tadashi101/teen_circle/README.md

# teen circle  
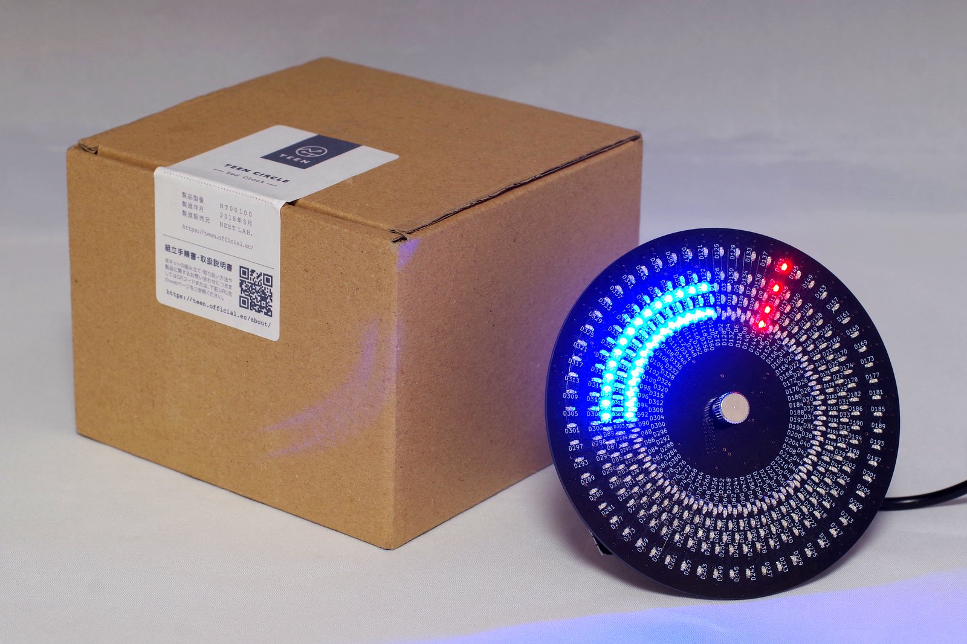
[picture p1: image/image_README.JPG]
TEEN_CIRCLE
  
  
teen circleのgithubのページです
回路図、ファームウェア、組み立て説明書、使い方説明書などをまとめています  
  
Rev２から調光機能を追加しました。[設定方法はこちら](doc/usage.md)  
スマートフォンの画面からLEDの明るさを変更することができます  
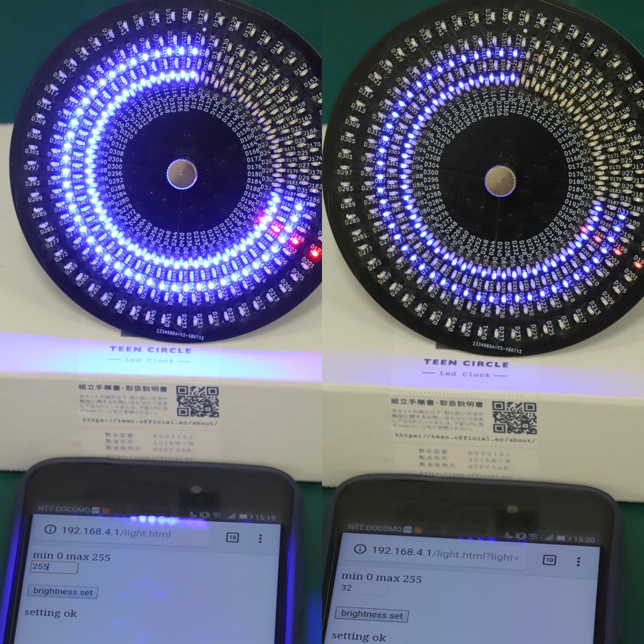
[picture p2: image/Rev2/image_rev2_comp.jpg]
light_comp
  

Rev3基板からUSB PD(9V)電源で動作するように変更されました。電源基板のレギュレータが熱くなる問題が解決されています。  
ファームウェアはRev 2以降で共通です  
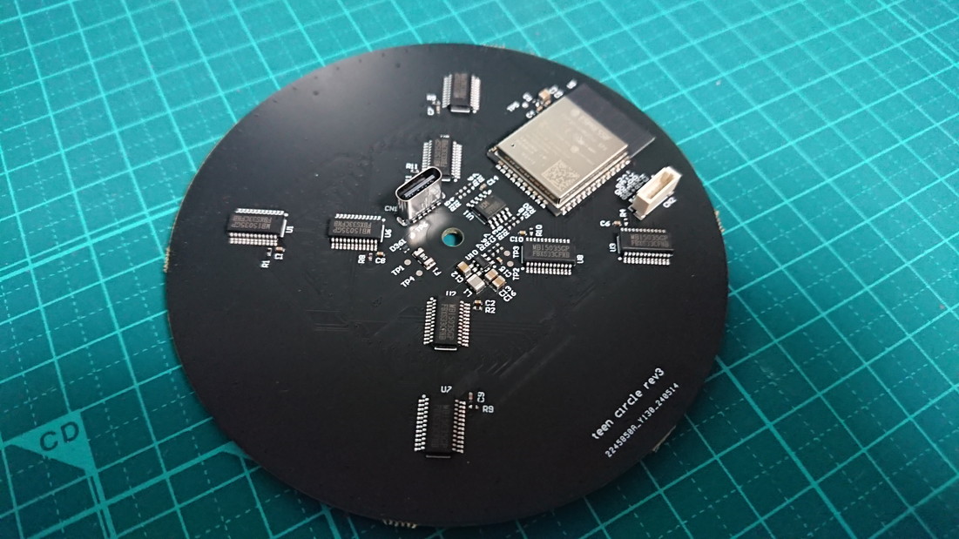
[picture p3: image/Rev3/image_rev3_usbc.jpg]
  
  
紹介動画  
表示できません (http://www.youtube.com/watch?v=WW388IgG8ik)
  
## Documents  
[組み立て説明書](doc/buildguide.md)  
組み立て方の説明です、部品の半田付け、組み立てなどが記載してあります  
  
[使い方説明書](doc/usage.md)  
[使い方説明書(Wi-Fi Manager対応版)](doc/usage_2.md)  
使い方の説明です、時刻の設定方法が記載してあります  
  
[時刻の読み方](doc/dial.md)  
時刻の読み方が記載してあります  
  
## ファームウェア  
[書き込み方法](doc/flash.md)  
使用してるマイコンESP32の書き込み方法を記載しています
