tadashi101/teen_circle/firmware/Rev2/led_clock/README.md

# TEEN CIRCLE Rev.2 向け NTP & Wi-Fi Manager 対応ファームウェア

## 使い方

1. Arduino IDE で、`led_clock.ino` をビルドし、書き込みます。ファームウェアの書き込み方法については [こちら](https://github.com/mizuhiki/teen_circle/blob/master/doc/flash.md) を参照してください。
2. 続けて`flash_spiffs.bat`を実行してWeb UI用のデータをアップロードします。失敗するときやWindows以外のOSの場合は書かれているスクリプトを各自の環境に合わせて修正してください
