tadashi101/teen_circle/doc/flash.md

# ファームウェアの書き込み方法
同梱されてるWi-FiモジュールESP-WROOM-32(ESP32)にはあらかじめファームウェアを書き込んでいます
このページの内容はファームウェアをアップデート、もしくは変更したい人向けになります  
  
## Rev2基板までの場合
1. ハーフピッチで2列の[ピンヘッダ](http://www.aitendo.com/product/6880)、[ピンソケット](http://www.aitendo.com/product/11345)などをJ3に半田付けします  
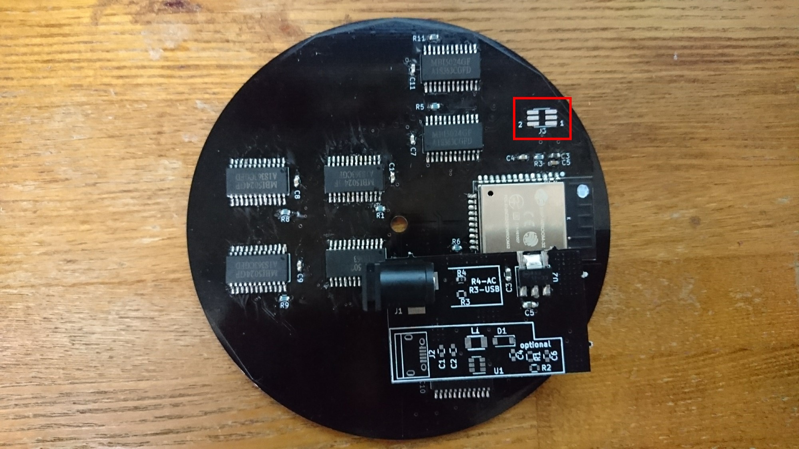
[picture p4: image/image_flash_1.jpg]
J3
  
  
2. 3.3VのUSB-UARTを用意します。[秋月電子](http://akizukidenshi.com/catalog/g/gM-05840/)や[aitendo](http://www.aitendo.com/product/2890)などで購入できます  
  
3. J3の3ピンがESP32側のRX,5ピンがTXなのでUSB-UARTのTXとRXを半田付けし、さらにGNDもつなぎます  
秋月電子さんのUSB-UARTの場合は以下の様な接続になります  
  
| USB-UART | 　 | J3 |
|---:|---:|---:|
| GND　黒 | - | GND 2ピン |
| CTS　茶 |  |  |
| ５V　赤 |  |  |
| TXD　橙 | - | RX ３ピン |
| RXD　黄 | - | TX ５ピン |
| RTS　緑 |  |  |
  
J3のピン配置は以下の様になります  
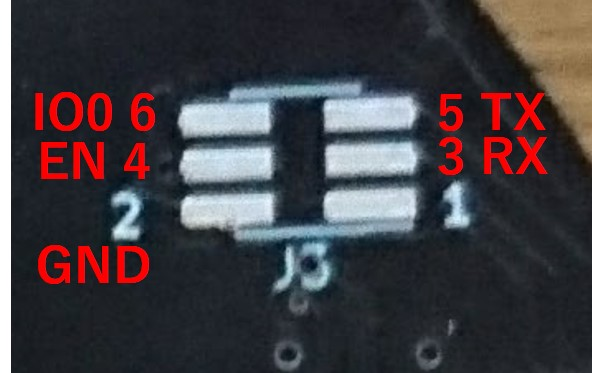
[picture p5: image/image_flash_2.jpg]
J3ピン配置
  
  
4. ESP32のファームウェアを書き込むモードにするためにはEN(J3:4ピン)とIO0(J3:6ピン)をGNDに落とす必要があります  
IO0(J3:6ピン)をGNDに落としたままにするとファームウェア書き込みモードに固定されるため、  
EN、IO0とGNDの間に[スイッチ](http://akizukidenshi.com/catalog/g/gP-03646/)を接続し、スイッチを押すとEN,IO0がGNDと接続されるようにします  
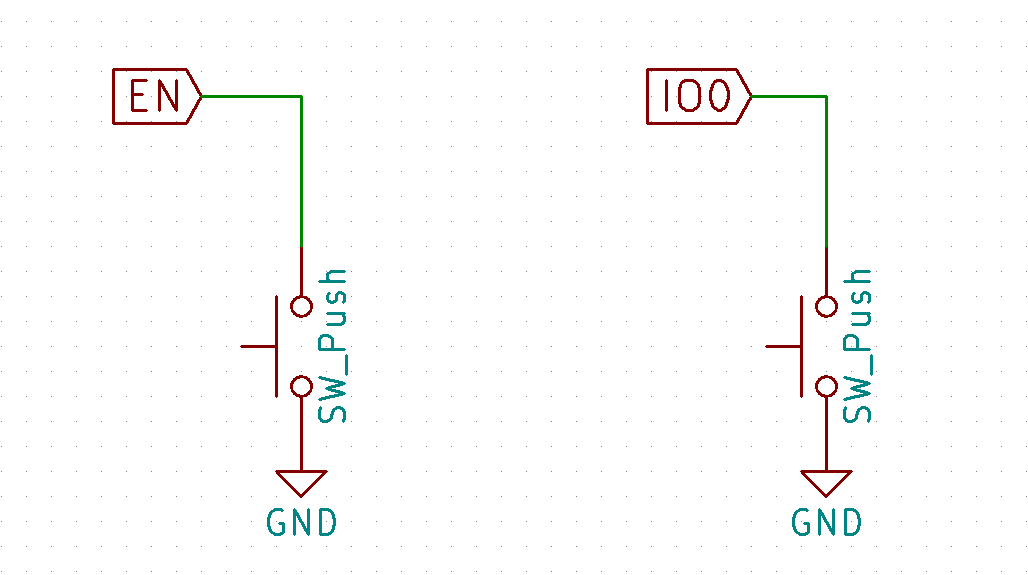
[picture p6: image/image_flash_3.PNG]
EN,IO0接続
  
  
5. ファームウェアをビルドします。ビルドする方法は将来書くかもしれません  
  
6. ファームウェアを書き込みます  
(1)Arduino IDEの場合  
スケッチ→マイコンボードのの書き込みをクリックします  
Connecting.......の表示になると、ENとIO0両方のスイッチのボタンを押し、ENのスイッチだけボタンを離します  
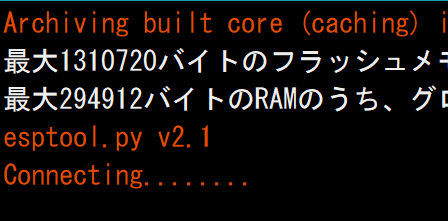
[picture p7: image/image_flash_4.PNG]
Connect
  
Writing～の表示になるとIO00側のボタンも離します  
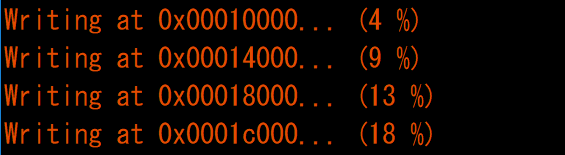
[picture p8: image/image_flash_5.PNG]
Writing
  
Hard resetting..の表示になったらファームウェアが書き込めてます  
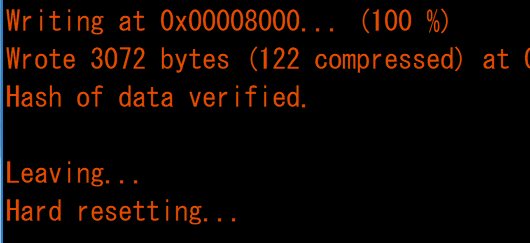
[picture p9: image/image_flash_6.PNG]
Hard_reset
  
リセットするためにENのスイッチのボタンを押して、離します

これでリセットがかかり、書き込まれたファームでESP32が起動します  

## Rev3基板の場合
1. JSTのSH6Pコネクタ付ケーブルまたは[互換品](https://akizukidenshi.com/catalog/g/g114535/)を用意します
  
2. [CP2104/CH9102搭載 ESP32 ダウンローダキット](https://akizukidenshi.com/catalog/g/g117240/)または相当品のESP32書き込み基板を用意します
  
3. CN2とダウンローダキットをSH6Pケーブルで接続します  
  
| ESP32ダウンローダキット | 　 | CN2 |
|---:|---:|---:|
| GND | - | GND 6ピン |
| G0 | - | PROG 5ピン |
| EN | - | EN 1ピン |
| RXD | - | RX ３ピン |
| TXD | - | TX 2ピン |
| 3.3V | - | 3.3V 4ピン |
  
ピン配置は基板のシルクも参考にして接続してください
CP2104/CH9102搭載 ESP32 ダウンローダキット以外のESP32書き込み基板を使用する場合はTXD/RXDの定義が逆のこともありますので注意ください
    
4. ファームウェアをビルドします。ビルドする方法は将来書くかもしれません  
  
5. ファームウェアを書き込みます  
(1)Arduino IDEの場合  
スケッチ→マイコンボードのの書き込みをクリックします  
Connecting.......の表示になると、ENとIO0両方のスイッチのボタンを押し、ENのスイッチだけボタンを離します  
Connect  
Writing～の表示になるとIO00側のボタンも離します  
Writing  
Hard resetting..の表示になったらファームウェアが書き込めてます  
Hard_reset  
リセットするためにENのスイッチのボタンを押して、離します

これでリセットがかかり、書き込まれたファームでESP32が起動します
