tadashi101/teen_circle/doc/dial.md

# 時間の読み方

TEEN CIRCLEは、組み立てた後も楽しく時計を使っていただくため、特徴的な文字盤のデザインとなっています  
LEDの文字盤ならではの時刻表現は、ほんの少しコツを掴めば、アナログ時計や７セグの時計よりも直感的に時の流れを感じてもらうことができます  
  
## 「時」の読み方  
青色のLEDは「時」を表します  
日の昇り沈みを示すように、午前は青色LEDの点灯数が増え続け、午後は順番に消灯していきます  
午前と午後で時刻の表示が異なるのが特徴です    

午後１２時（午前０時）では青色のLEDが１列点灯している状態になります  
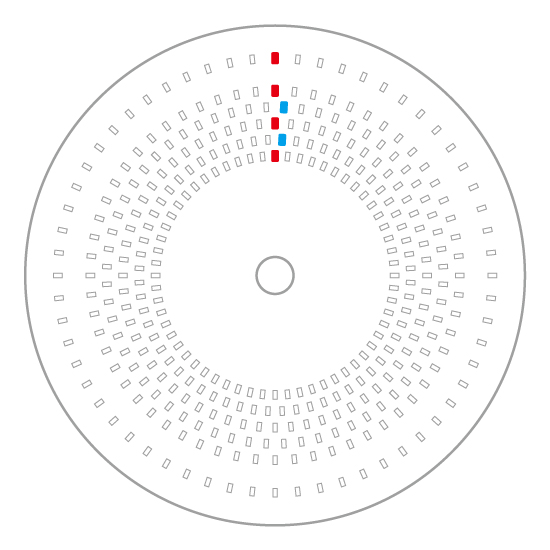
[picture p10: image/image_dial_01.jpg]
文字盤_0:00
 
  
午前中は一時間ごとに点灯する青色のLEDが増えます  

下図は「午前３時ちょうど」です  
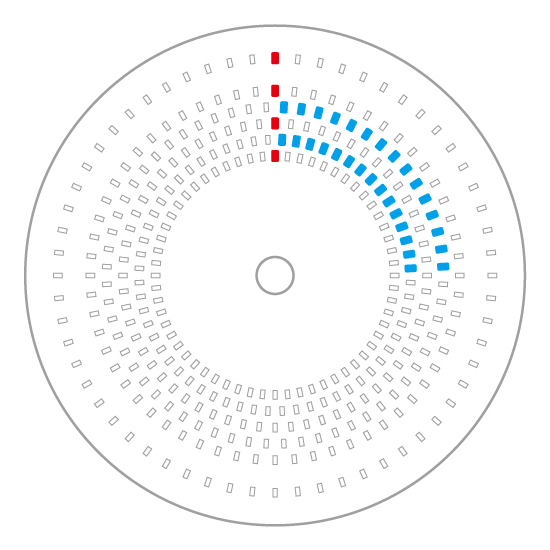
[picture p11: image/image_dial_02.jpg]
文字盤_3:00
  
  
午前１２時(正午)になると、青色のLEDは一周点灯する状態になります  
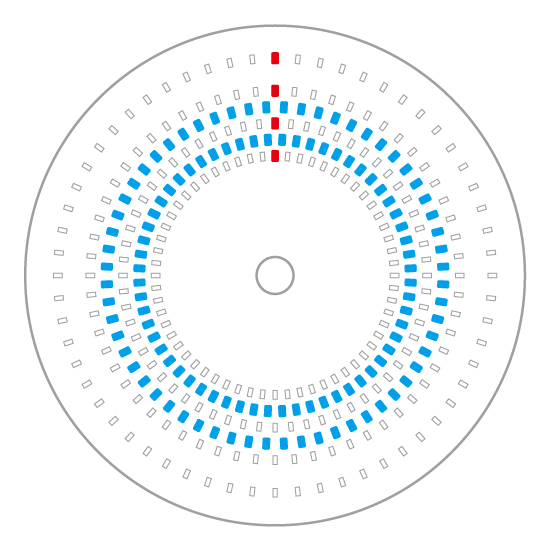
[picture p12: image/image_dial_03.jpg]
文字盤_12:00
  
  
午後１時からは、青色のLED表示が順番に消えてます  
下図は「午後３時（15時）ちょうど」です  
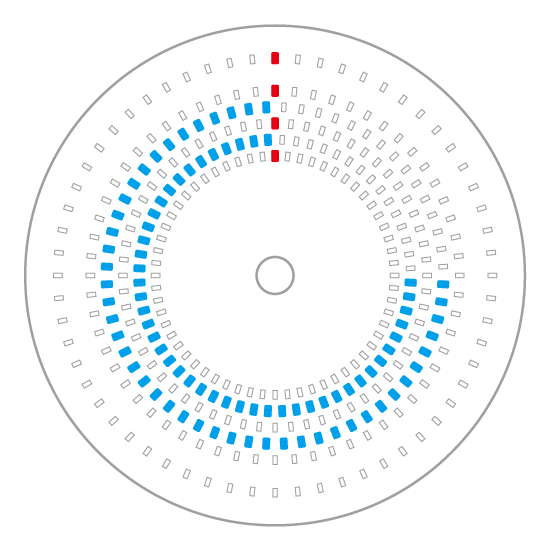
[picture p13: image/image_dial_04.jpg]
文字盤_15:00
  

## 「分」の読み方  
赤色のLEDは「分」を表します  
赤色のLEDはアナログ時計の分針と同じ動きをします  
下図は「午前９時１０分」です  
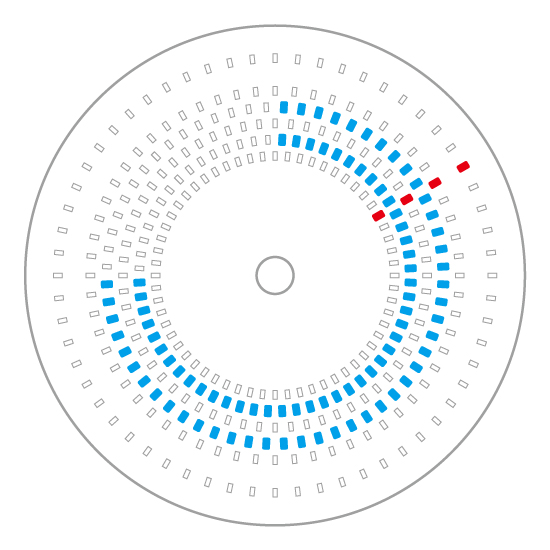
[picture p14: image/image_dial_05.jpg]
文字盤_9:10
  

分針である赤色のLED表示は午前も午後も同じ動きをします  
下図の場合は「午後９時１０分（２１時１０分）」です  
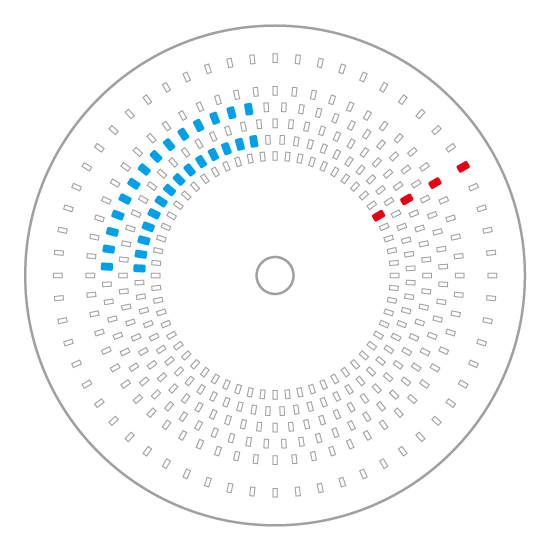
[picture p15: image/image_dial_06.jpg]
文字盤_21:10
