tadashi101/teen_circle/doc/buildguide.md

# 組み立て説明書  
## 内容物  
  
| 名称 | 必要数 | 備考 |
|---:|---:|---:|
| LED基板 | 1 |  |
| 電源基板 | 1 | 実装済み |
| LED赤 | 240 | 少し多めに入れてます |
| LED青 | 120 | 少し多めに入れてます |
| LEDドライバ MBI5024 | 8 |  |
| ESP-WROOM-32 | 1 |  |
| 抵抗10k 1608サイズ | 11 | 1個余分に入ってるかも |
| コンデンサ10u 1608サイズ | 1 | Rev2から予備も含めて3つ入れてます |
| コンデンサ0.1u 1608サイズ | 10 | 1個余分に入ってるかも |
| ピンヘッダオス 2×3 1.27mmピッチ | 1 | Rev2から2.54mmピッチ |
| ネジ | 1 |  |
| スペーサー | 1 | (Rev2から廃止) |
| Tバー | 1 |  |
| ワッシャー | 1 | (Rev2から廃止) |
| ACアダプタ9V1.3A | 1 |  |  
  
半田付け後の基板はこのようになります  
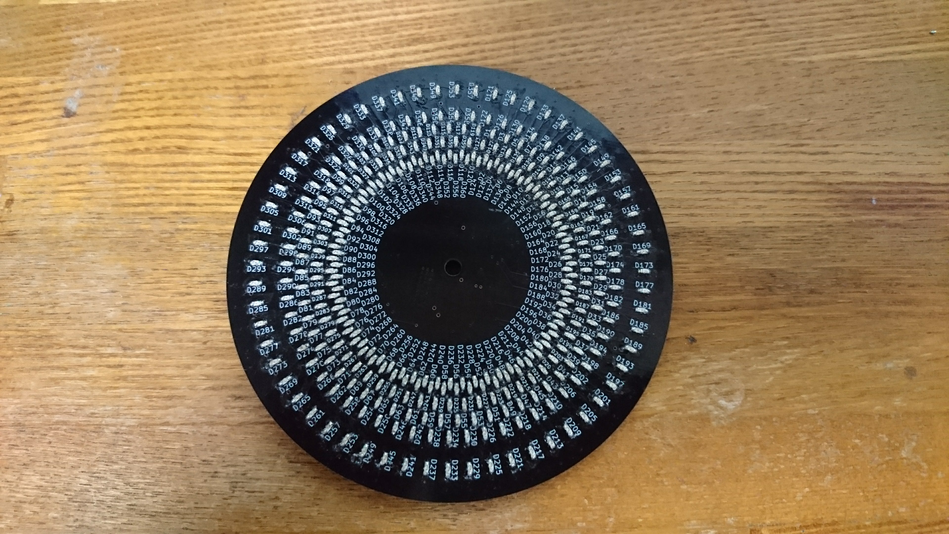
[picture p16: image/image_buildguide_1.jpg]
半田付け済みLED基板表

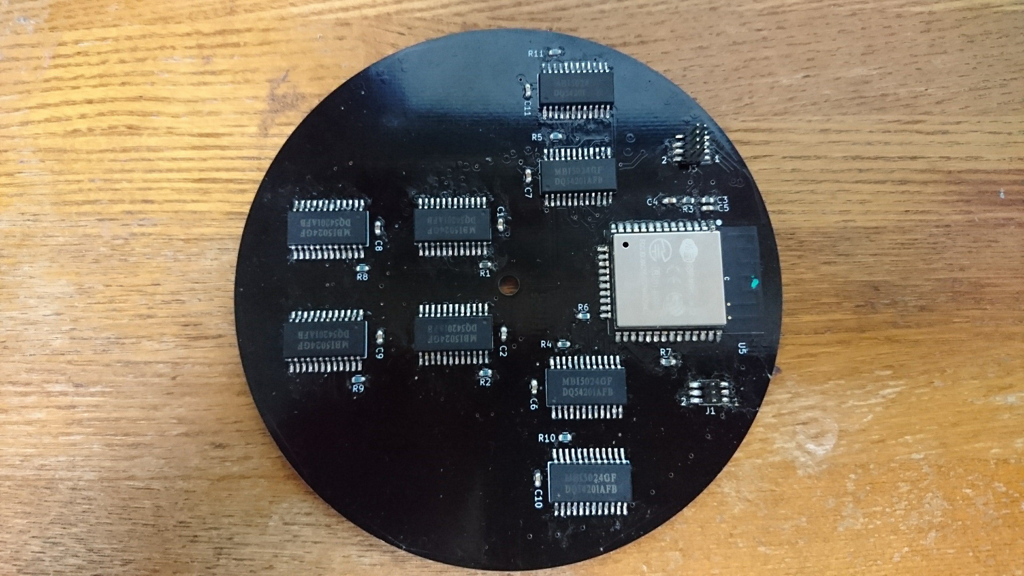
[picture p17: image/image_buildguide_2.jpg]
半田付け済みLED基板裏

  
Rev2では基板にシルクが記載されています  
またピンヘッダのピッチが2.54mmに変更されています  
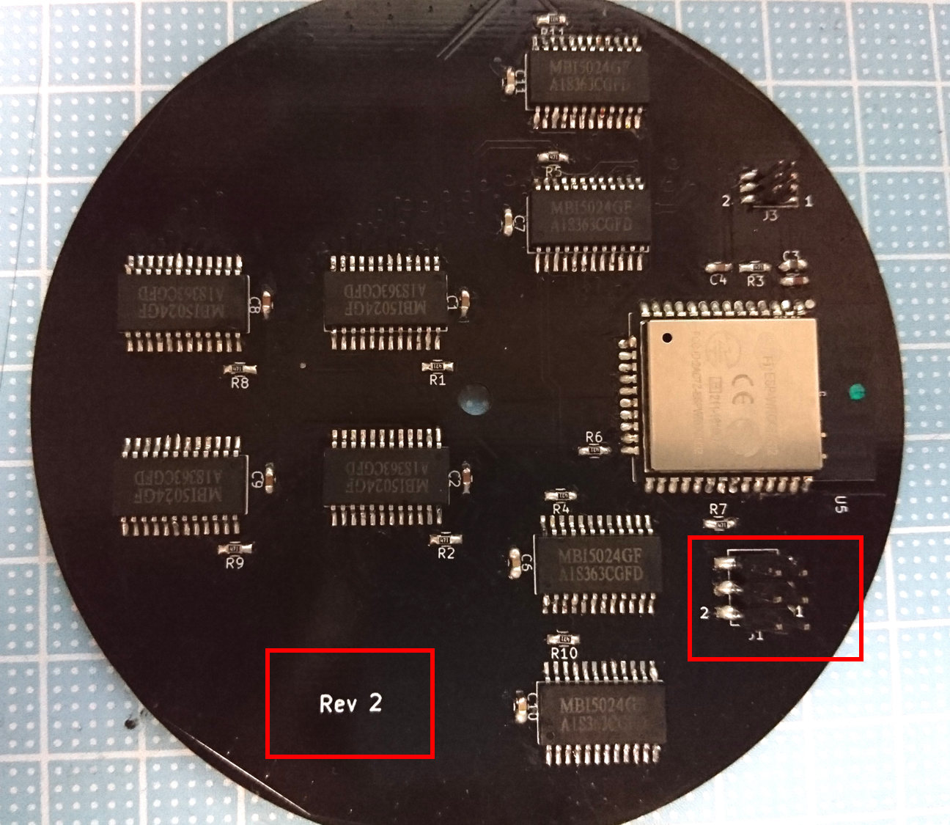
[picture p18: image/Rev2/image_rev2_buildguide_1.png]
Rev2半田付け済みLED基板裏
  
  
## LEDの半田付け  
LED赤とLED青を半田付けしていきます 
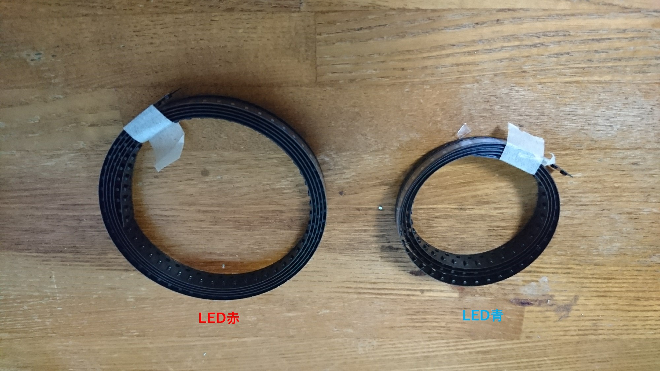
[picture p19: image/image_buildguide_3.jpg]
LED赤と青
  
LED赤は240個、LED青は120個実装します。量が多い方がLED赤です  
確認のためテスターで光らせて色を見てください  
4列縦に並んでいるのがLED赤のパッド、2列なのがLED青になります  
赤、青、赤、青・・・と交互に半田付けするのがやり易いです  
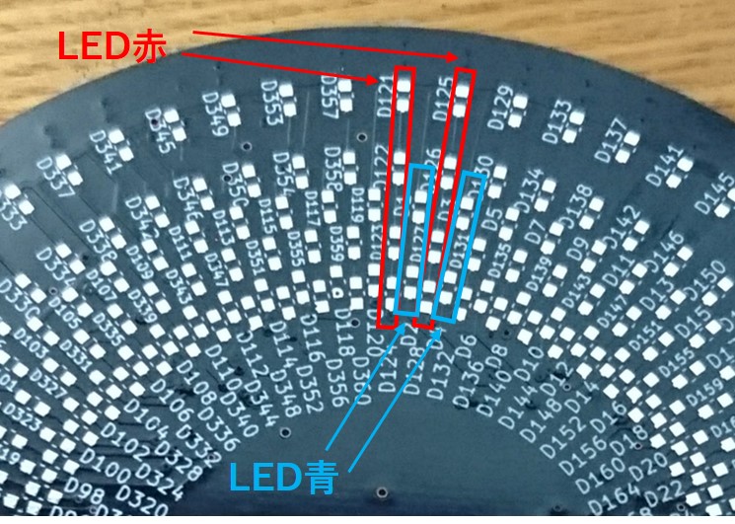
[picture p20: image/image_buildguide_4.jpg]
LED赤と青のパッド
  
LEDは方向があります。アノード→カソードの向きに電流が流れます  
逆に実装すると電流が流れず、LEDが点灯しません  
LEDはアノードが円の外側、カソードが円の内側になるように実装します  
LEDにはカソード側であることを示すマークがついています。このマークが円の内側になるように実装すれば、正しい向きに実装されます  
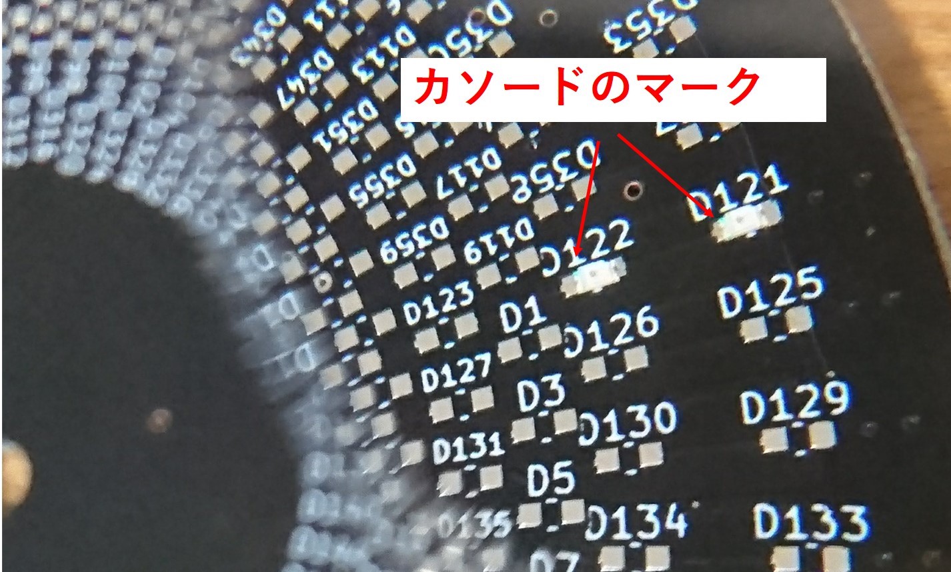
[picture p21: image/image_buildguide_5.jpg]
  
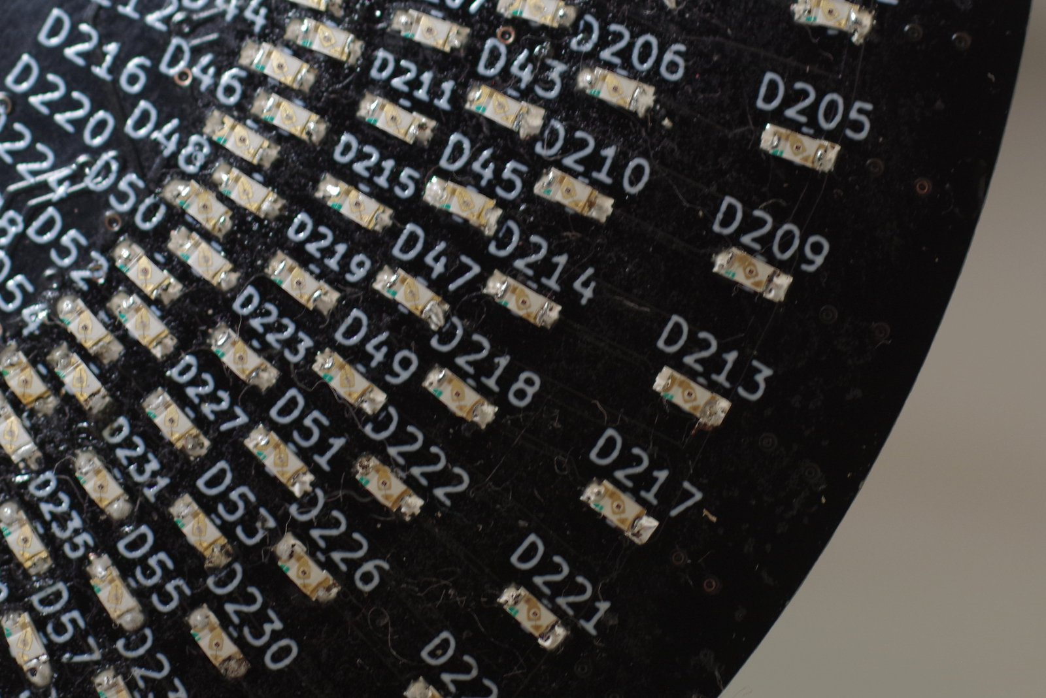
[picture p22: image/image_buildguide_5_2.JPG]

  
## LEDドライバの半田付け  
次に基板裏側にLEDドライバを半田付けします    
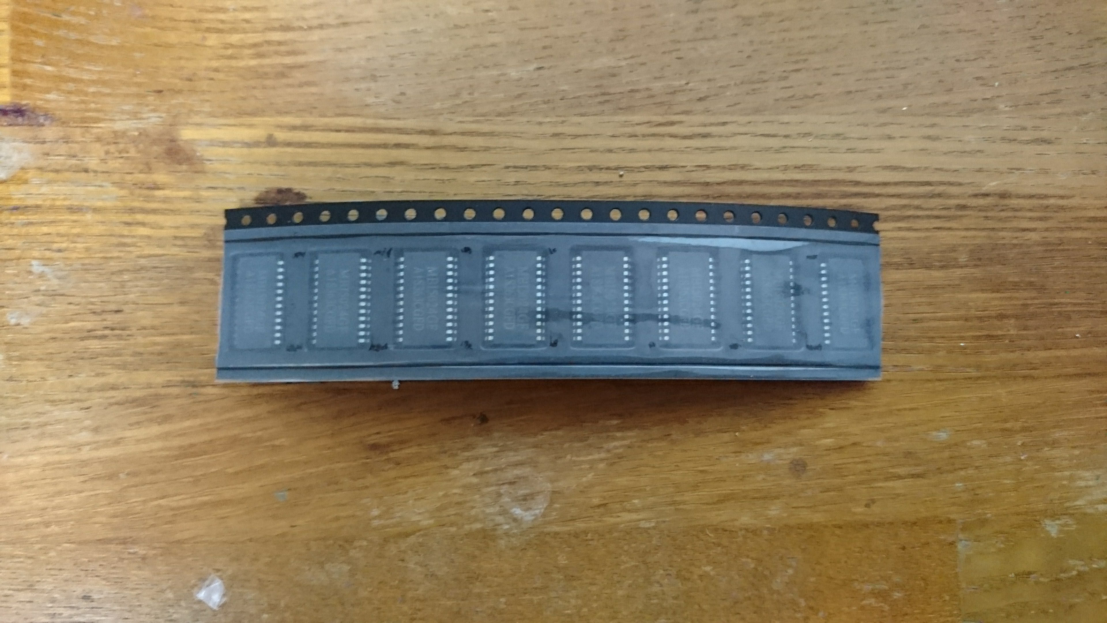
[picture p23: image/image_buildguide_6.jpg]
LEDドライバ
  
基板裏面のU1～U9に実装します  
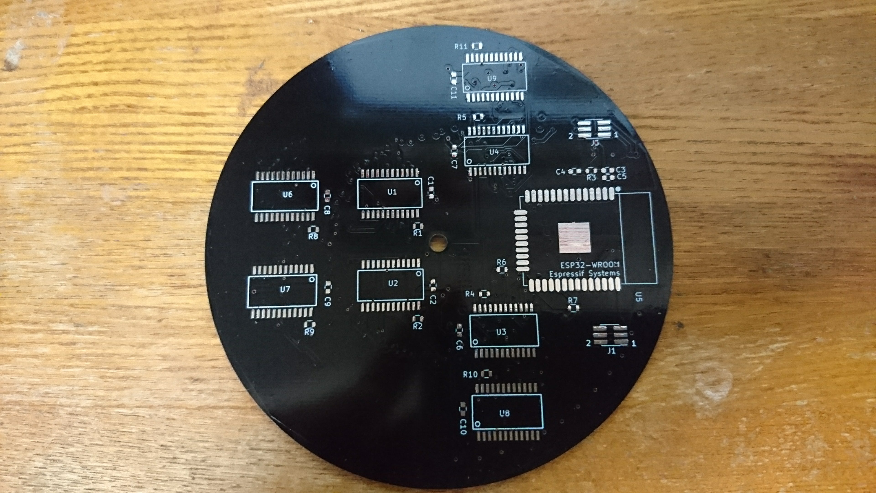
[picture p24: image/image_buildguide_7.jpg]
基板裏面
  
LEDドライバのマークと基板シルクのマークを合わせて実装します  
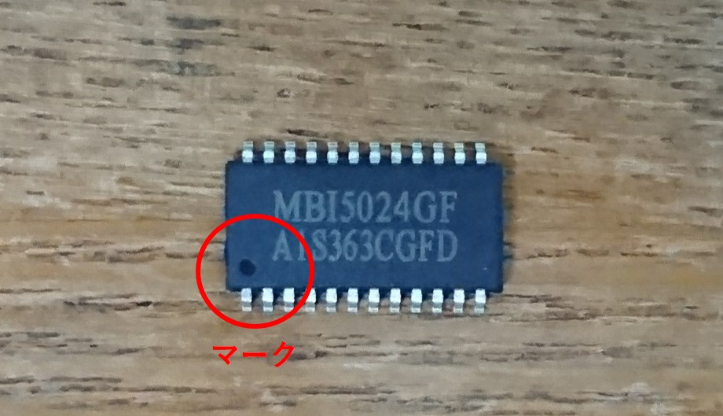
[picture p25: image/image_buildguide_8.jpg]
LEDドライバマーク
  
U1に乗せると以下のような向きになります  
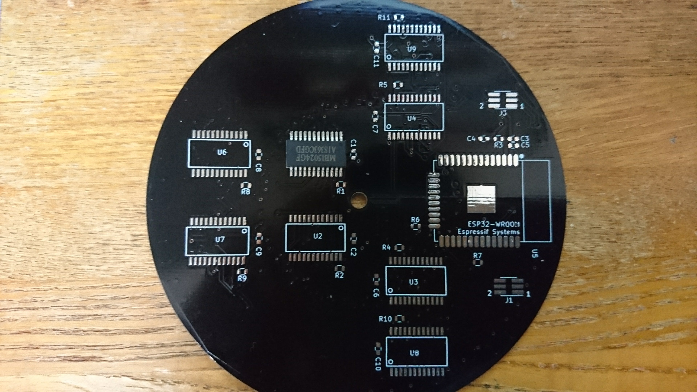
[picture p26: image/image_buildguide_9.jpg]
U1にLEDドライバ
  
U1からU9まで8個実装します(U5はESP-WROOM-32)  
ドライバの足の間隔が1mmと狭いです。隣の足と半田ブリッジさせないように注意してください  
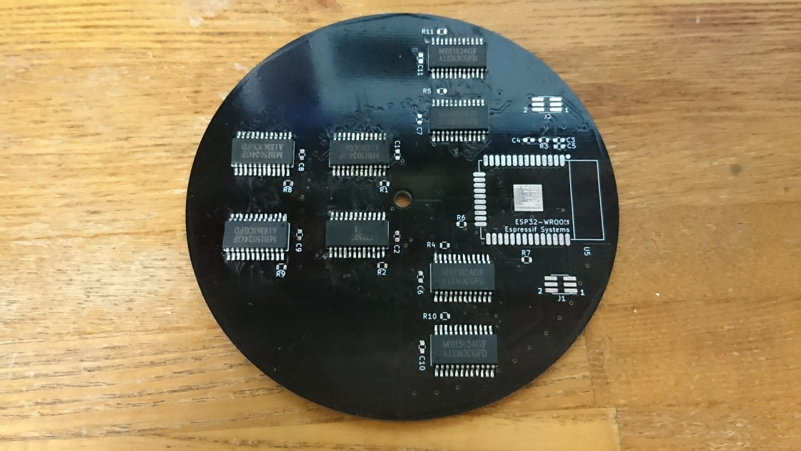
[picture p27: image/image_buildguide_10.jpg]
LEDドライバ実装
  
  
## ESP-WROOM-32の半田付け  
ESP-WROOM-32を半田付けします。ESP32と呼ばれてるWi-Fiモジュールです  
ファームウェアは既に書き込み済みです  
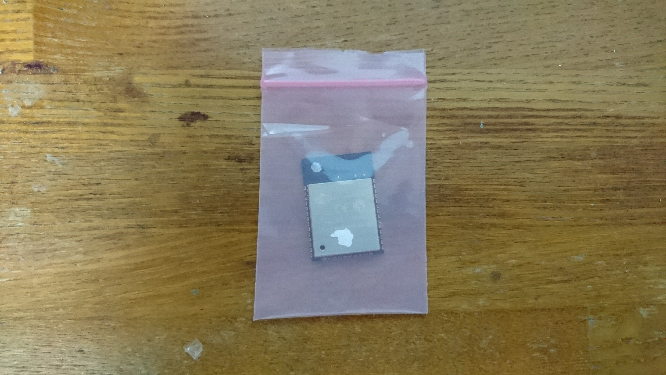
[picture p28: image/image_buildguide_11.jpg]
ESP-WROOM-32
   
半田付けが3辺あるので位置合わせを慎重に行ってください。 
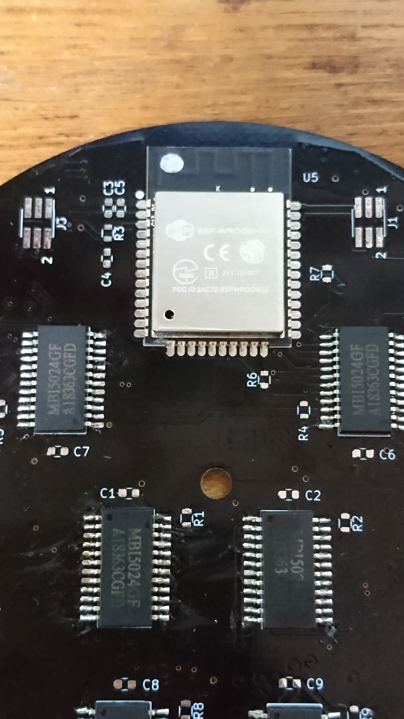
[picture p29: image/image_buildguide_12.JPG]
ESP-WROOM-32位置
 
  
## 抵抗・コンデンサの半田付け  
抵抗、コンデンサを半田付けします  
10uのコンデンサは電源基板に2つ半田付け済みなので、1つしか入っていません  
(10uのコンデンサはRev2から予備も含めて3つ入れています)  
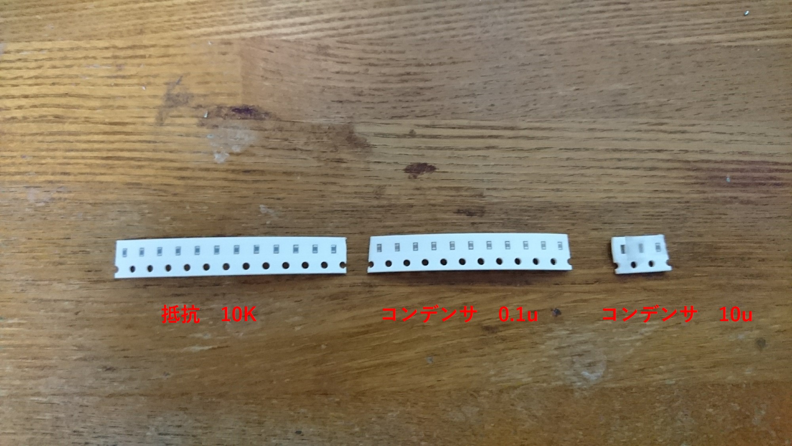
[picture p30: image/image_buildguide_13.JPG]
抵抗,コンデンサ
  
0.1uのコンデンサをC1,C2,C4,C5,C6,c7,C8,C9,C10,C11の計10個実装します  
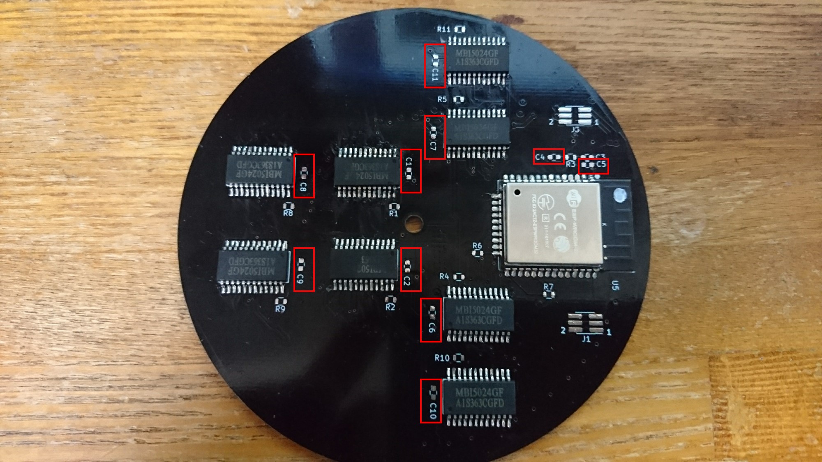
[picture p31: image/image_buildguide_14.jpg]
コンデンサ0.1u
   
10uのコンデンサをC3に実装します   
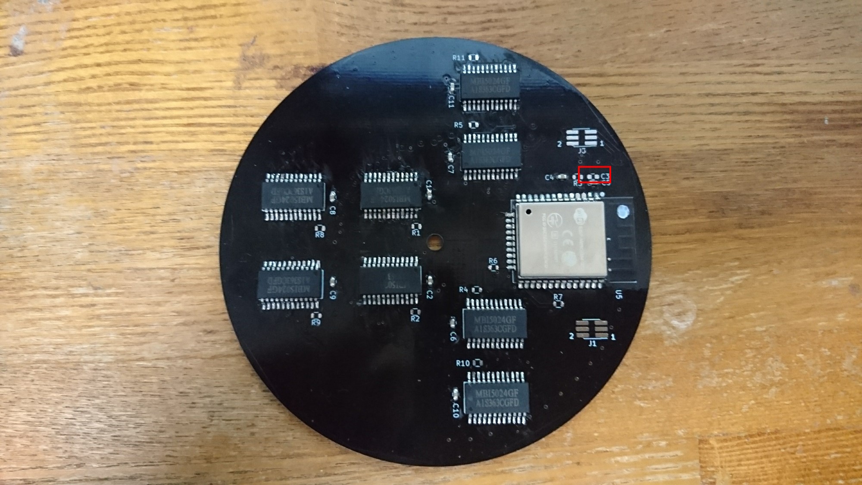
[picture p32: image/image_buildguide_15.jpg]
コンデンサ10u
  
10kの抵抗をR1～R11に11個実装します    
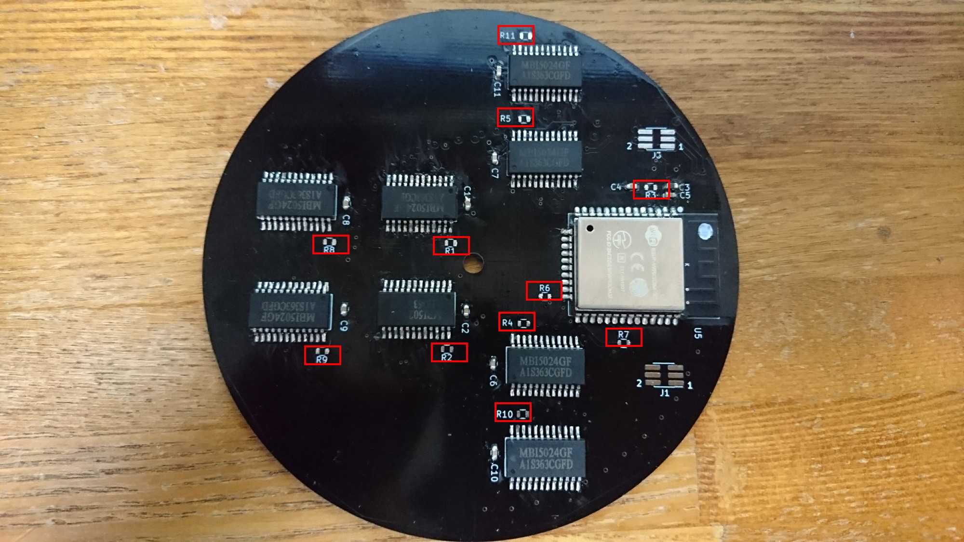
[picture p33: image/image_buildguide_16.jpg]
抵抗10k
  
  
## ピンヘッダの半田付け、電源基板、Tバーの組み立て  
電源基板を接続するためのピンヘッダを半田付けします  
以下のようなフィルムの中に入っています  
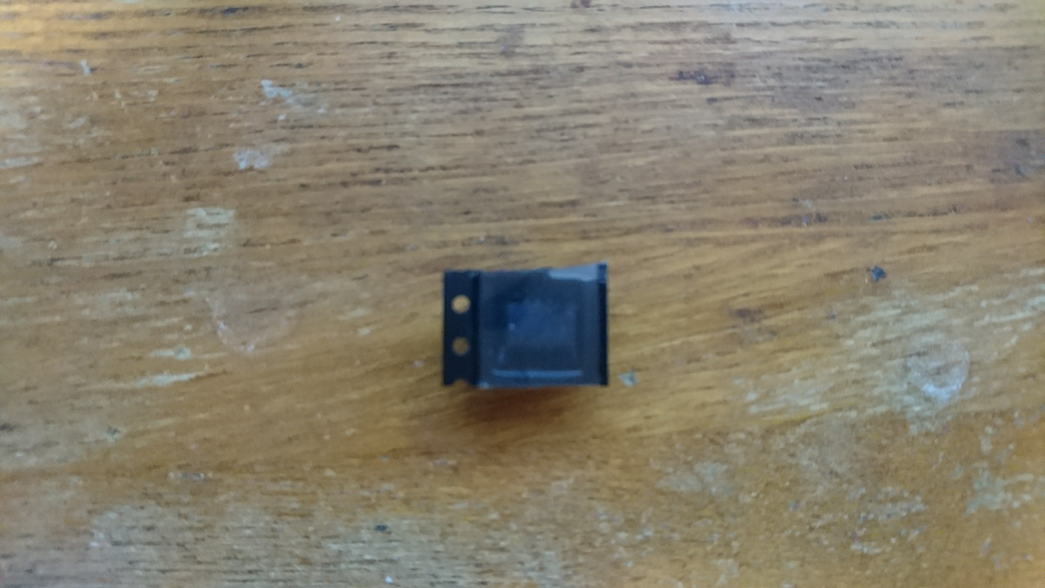
[picture p34: image/image_buildguide_17.jpg]
ピンヘッダ
  
Rev2ではそのまま入っています  
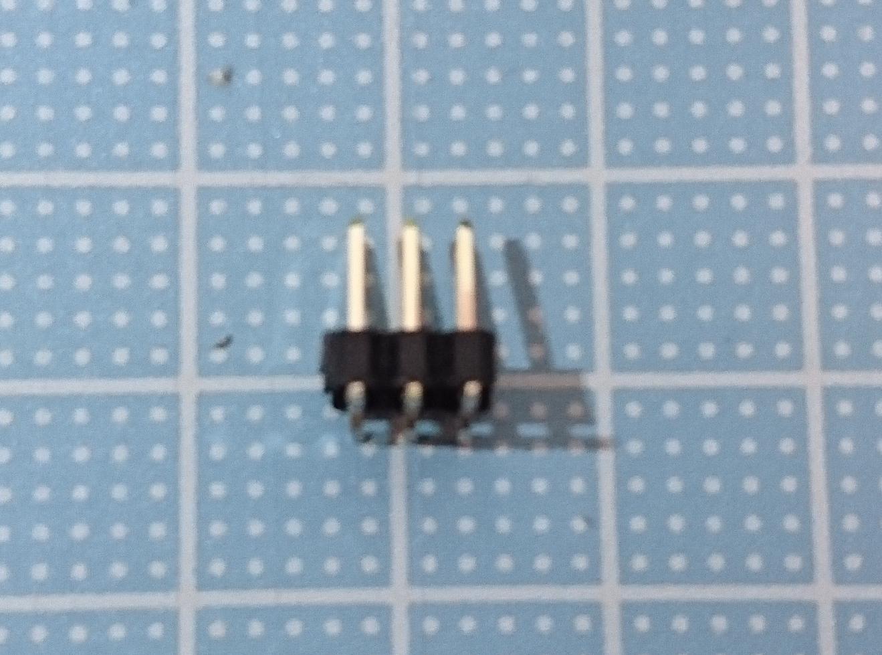
[picture p35: image/Rev2/image_rev2_buildguide_4.JPG]
Rev2_ピンヘッダ

  
J1のパッドに半田付けします  
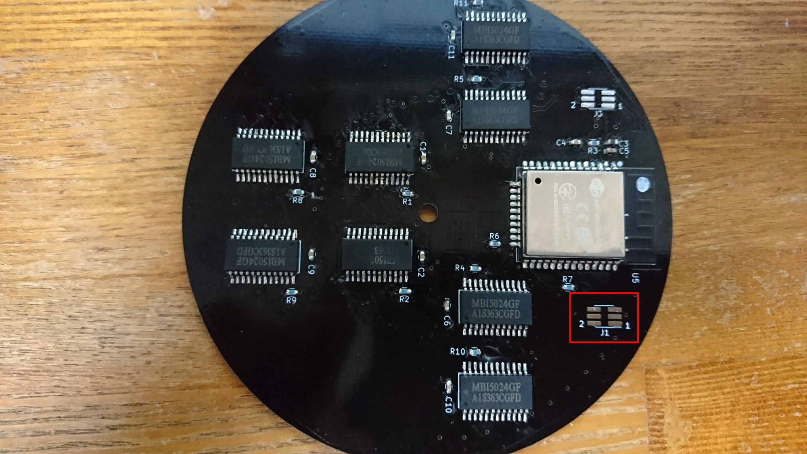
[picture p36: image/image_buildguide_18.jpg]
J1
  
半田付けは以上です   
J3のパッドですが、ESP32のファームウェア書き込み用です  
aitendoなどで1.27mmピッチの2列の[ピンヘッダ](http://www.aitendo.com/product/6880)、[ソケット](http://www.aitendo.com/product/11345)を購入して半田付けするとJ3のピンヘッダからファームウェアの変更ができるようになります  
  
スペーサー(ただのナノブロック)をLED基板裏に両面テープで貼り付けます  
スペーサーに両面テープは貼り付け済みです    
スペーサーを取り付けないと電源基板を接続したときに少しグラグラします  
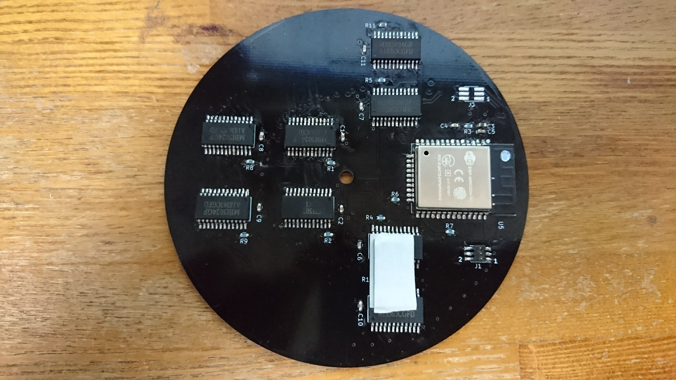
[picture p37: image/image_buildguide_19.jpg]
スペーサー
  
スペーサー上部の両面テープの剥離紙を剥がして、J3に実装済みの電源基板を接続します  
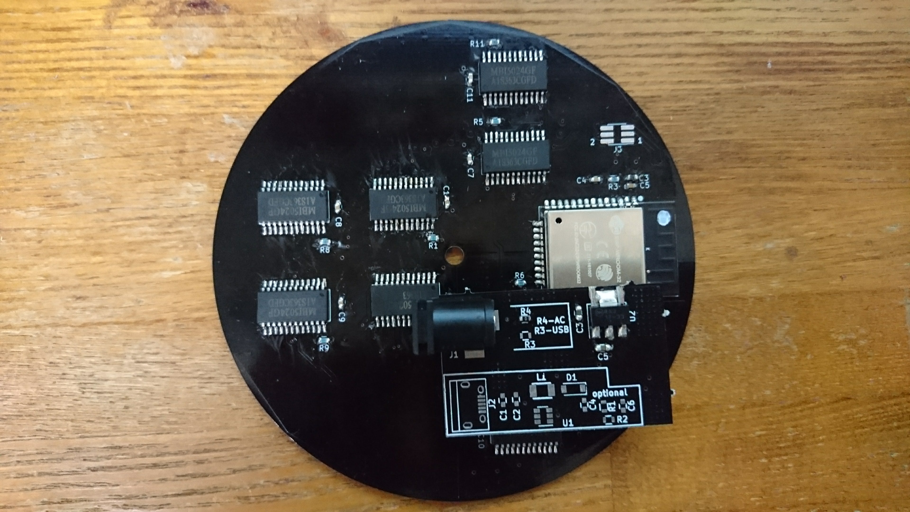
[picture p38: image/image_buildguide_20.jpg]
電源基板接続
  
  
Rev2では電源基板が変更になりスペーサーが廃止されています  
接続すると以下のようになります  
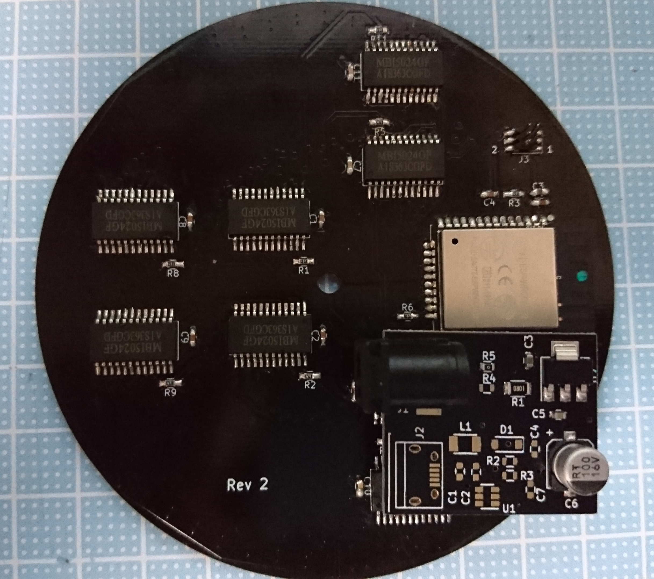
[picture p39: image/Rev2/image_rev2_buildguide_2.JPG]
Rev2電源基板接続
  
  
最後に基板とTバーの間にワッシャーをはさんで基板ごとネジで止めて完成です  
(Rev2ではワッシャーは廃止されています)  
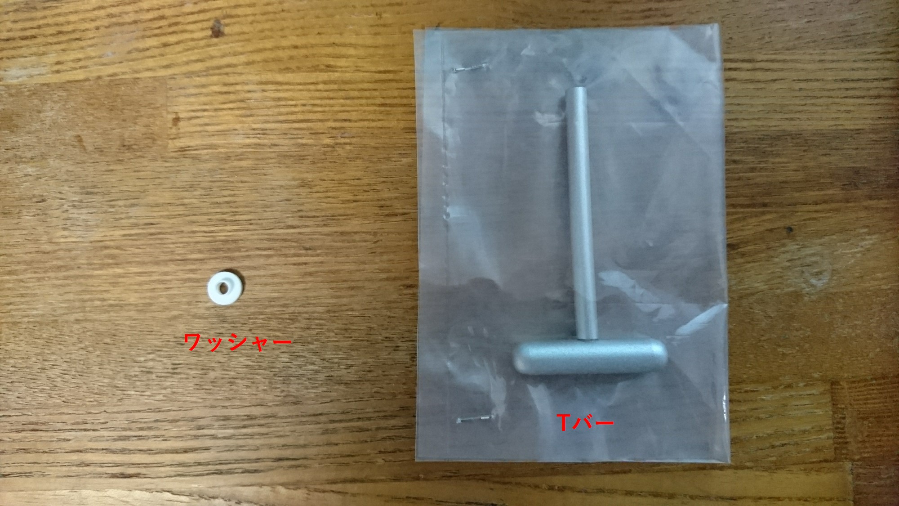
[picture p40: image/image_buildguide_21.jpg]
ワッシャー、Tバー
  
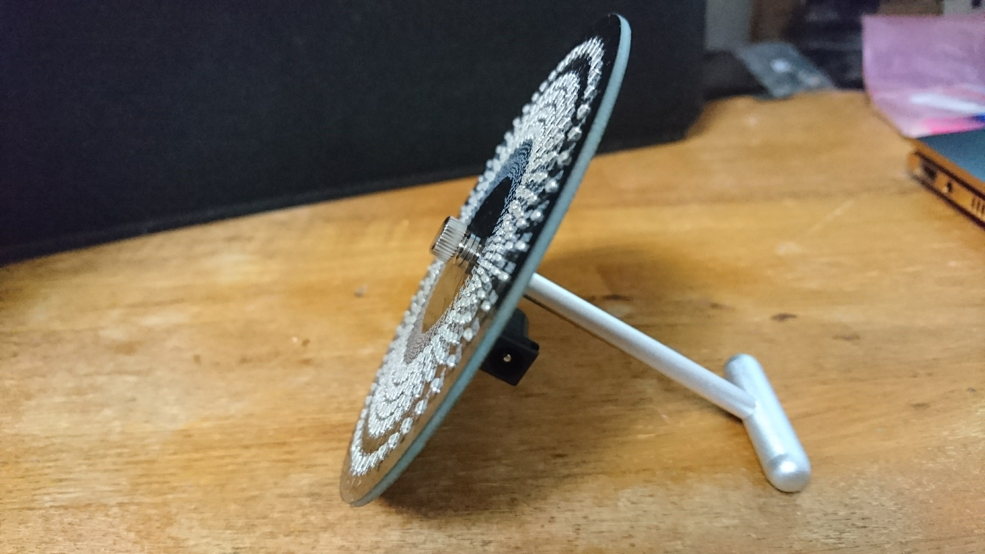
[picture p41: image/image_buildguide_22.jpg]
横から
  
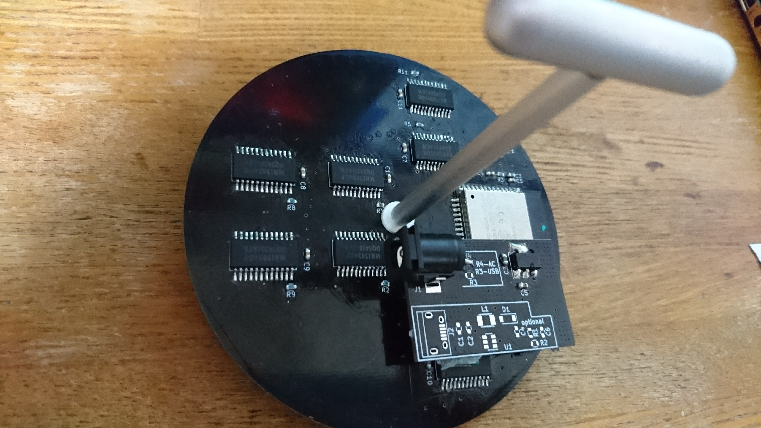
[picture p42: image/image_buildguide_23.jpg]
裏から
  
  
D121のシルクがある位置が０分の列になります   
この位置を真上にすると時間が読みやすくなります  
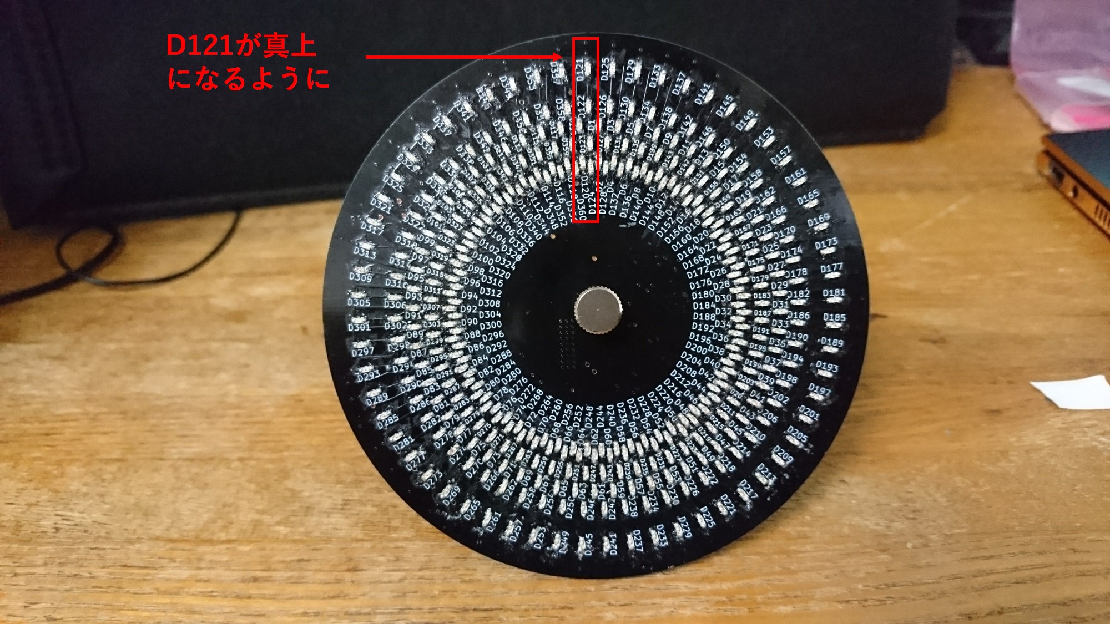
[picture p43: image/image_buildguide_24.jpg]
0分
  
  
Rev2から0分を表すシルクが追加になっています  
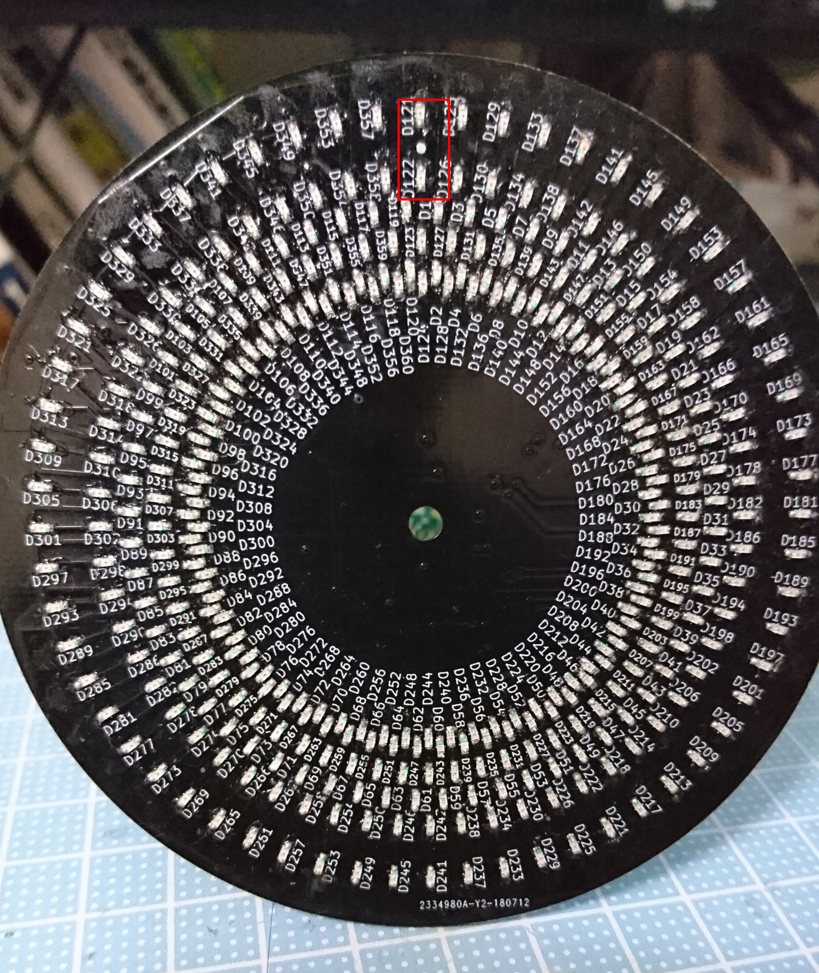
[picture p44: image/Rev2/image_rev2_buildguide_3.JPG]
Rev2_0分
  
# 注意点  
電源基板のレギュレータはかなり熱くなります。手を触れないようにお願いします
