tadashi101/teen_circle/sch/Rev3/led_clock_SCH_2024-05-11.PDF

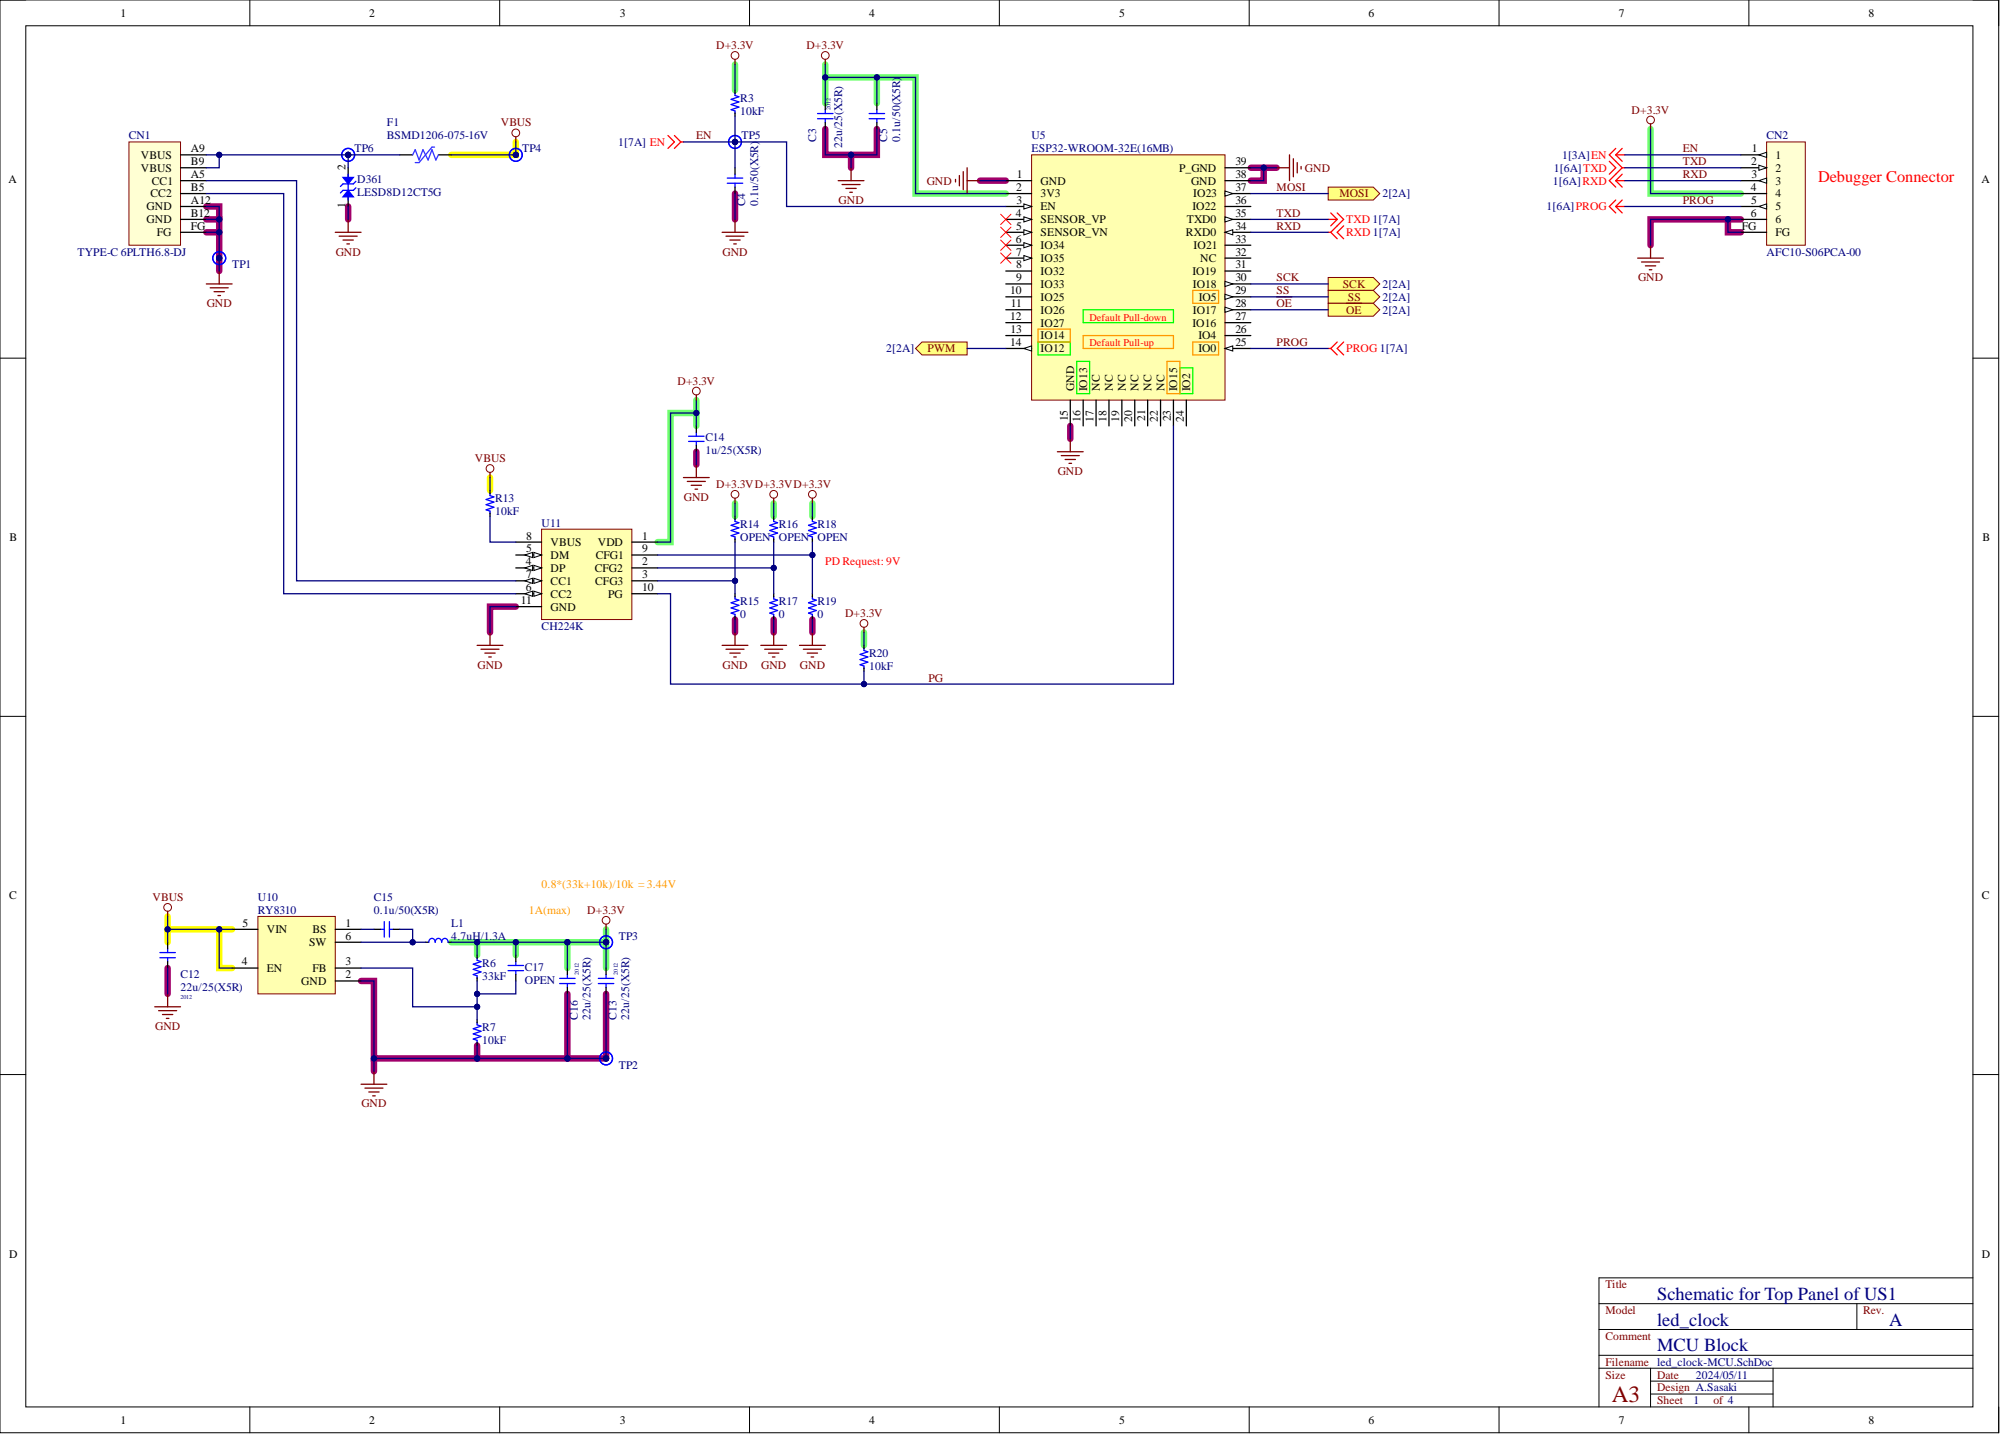
[picture p54: page 1]

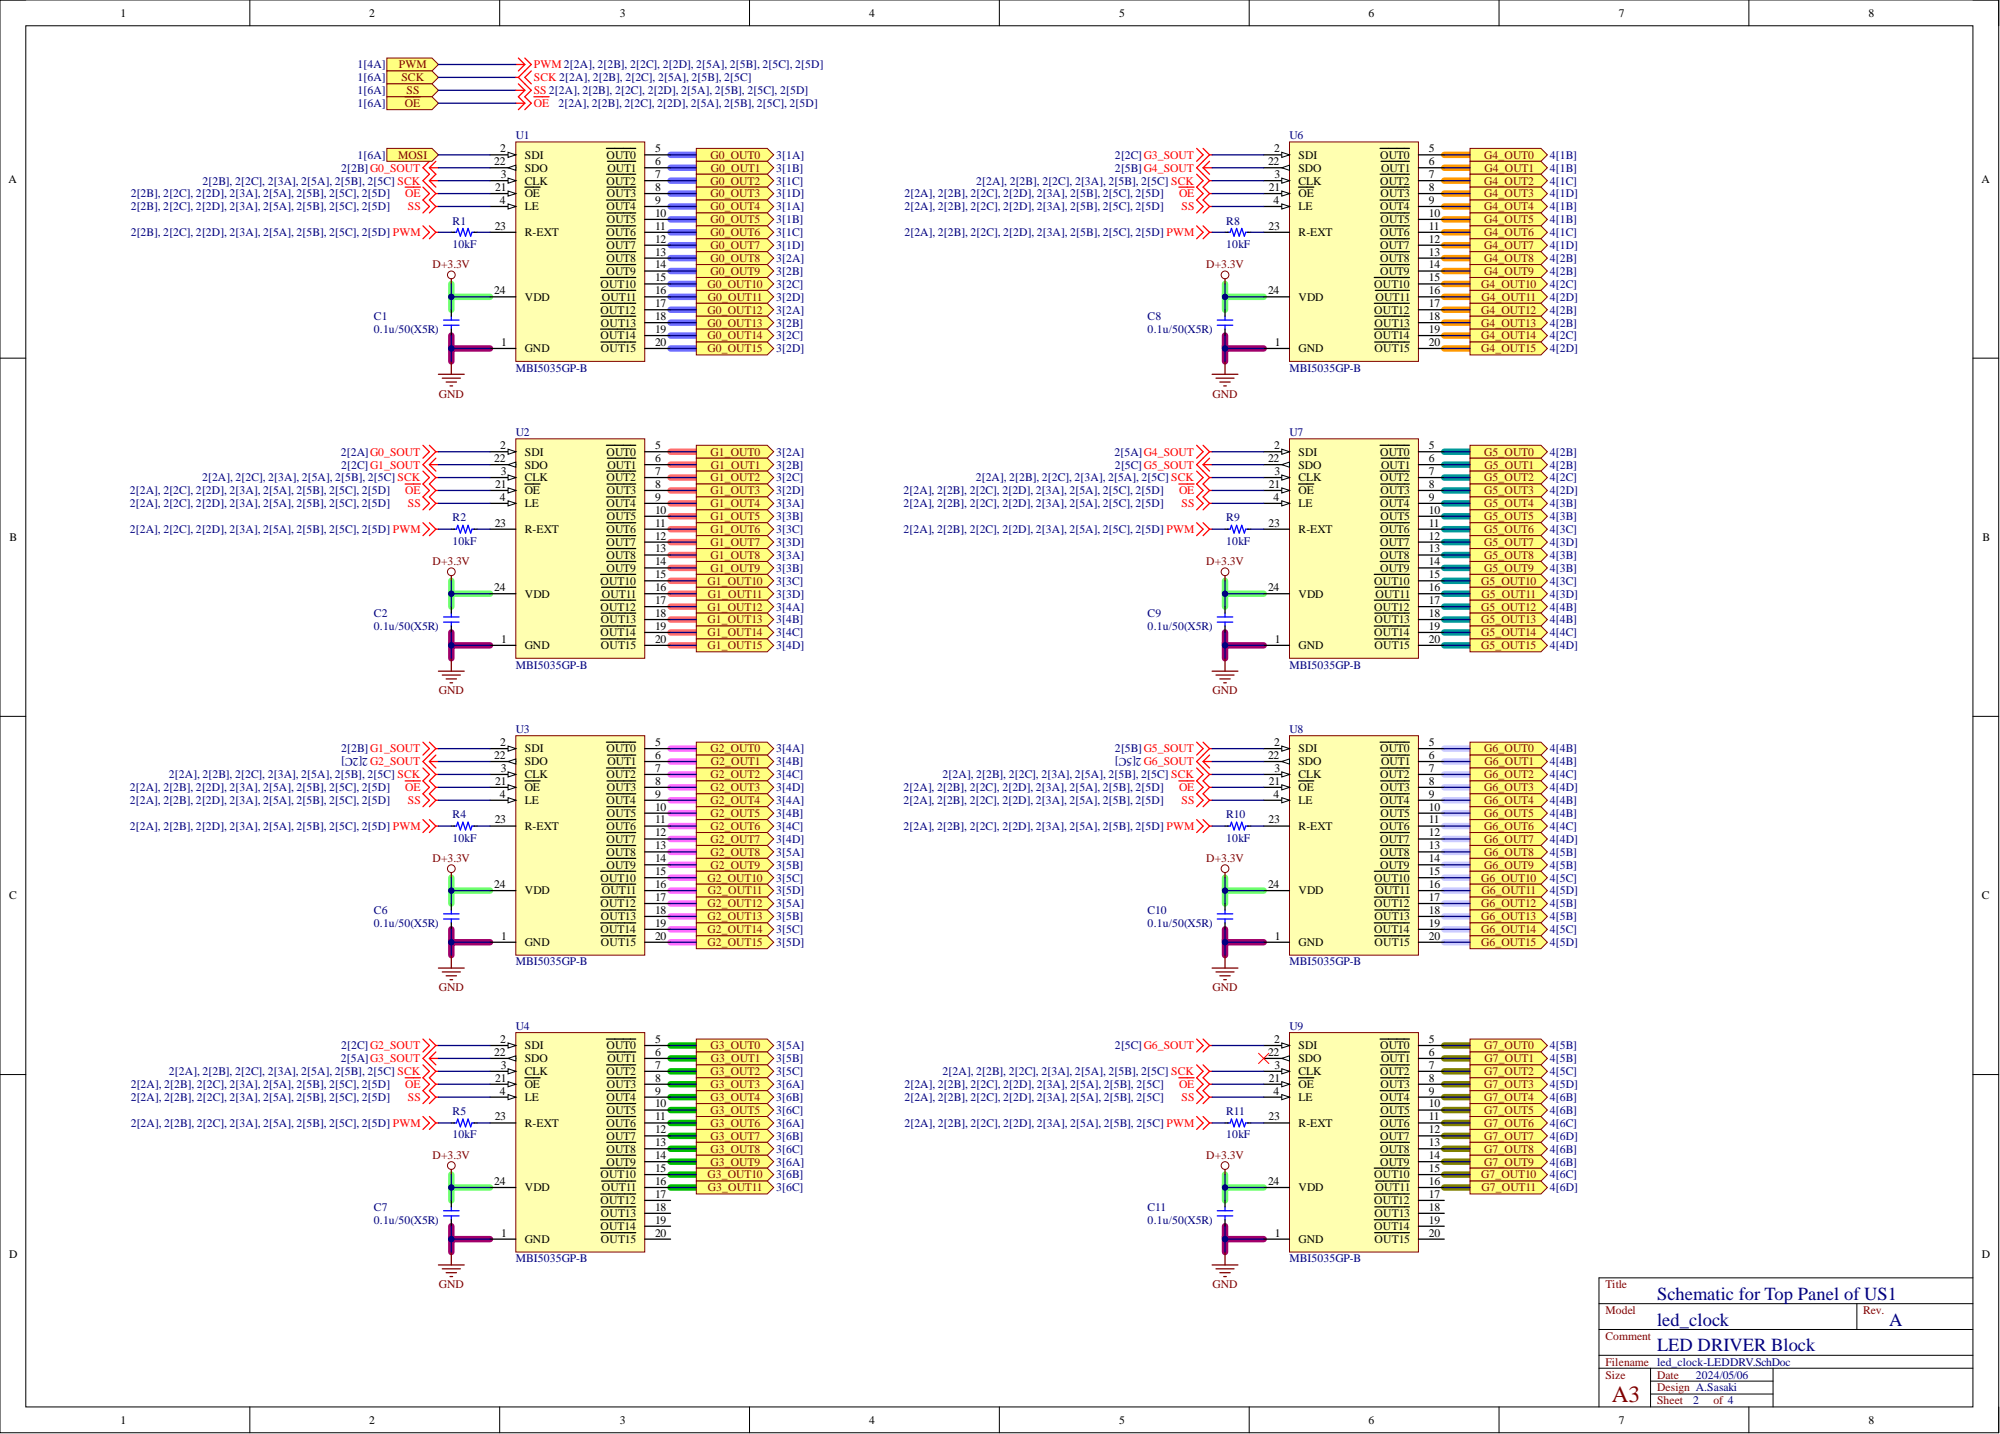
[picture p55: page 2]

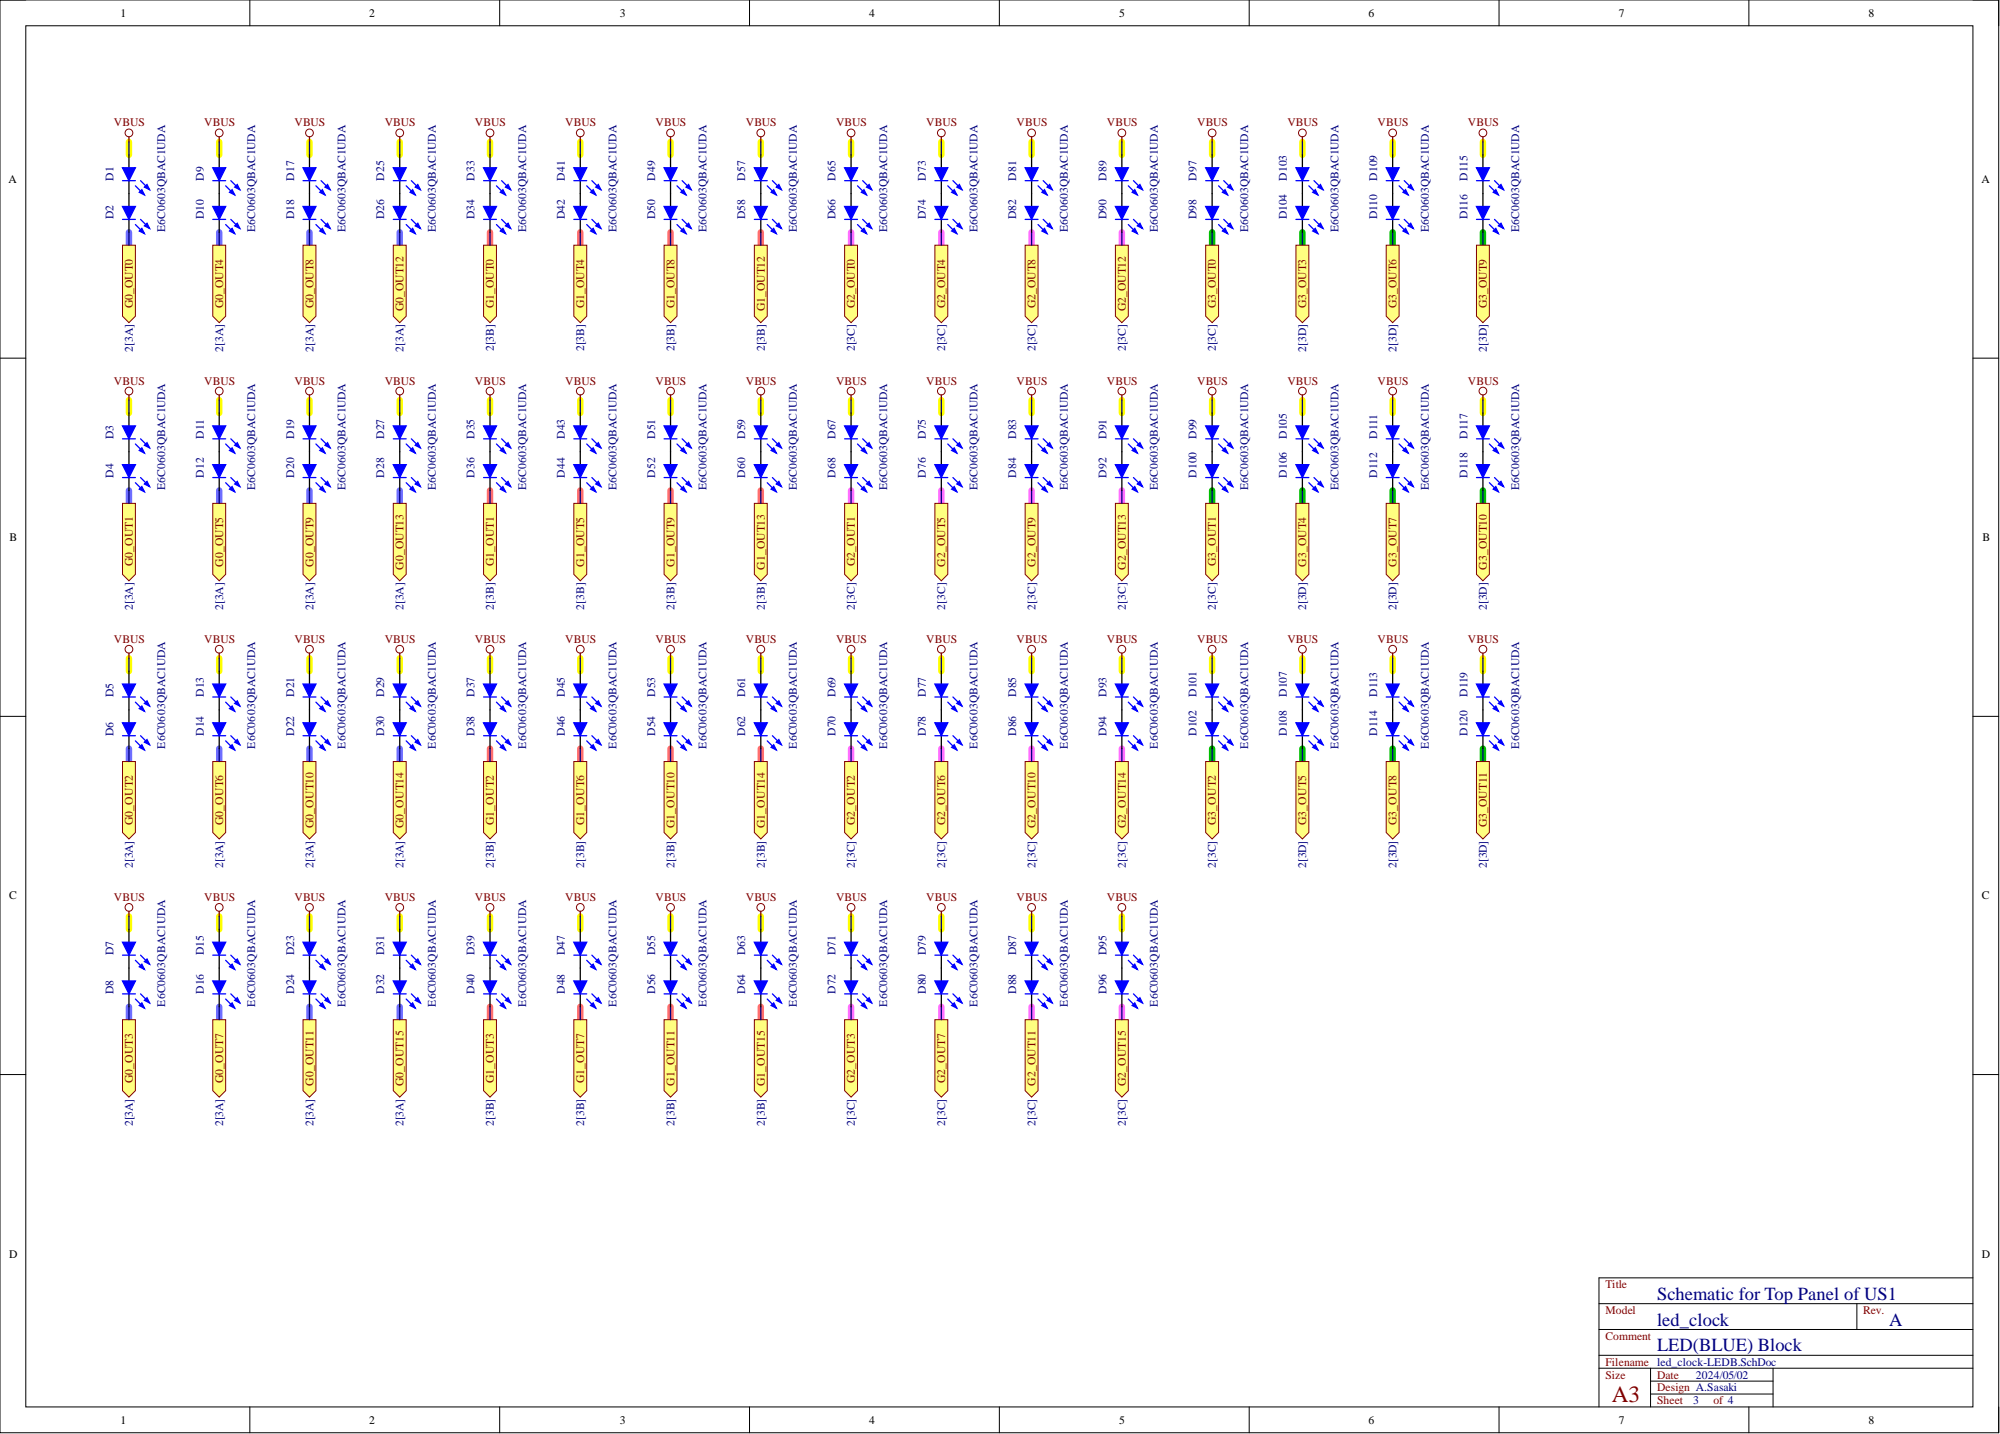
[picture p56: page 3]

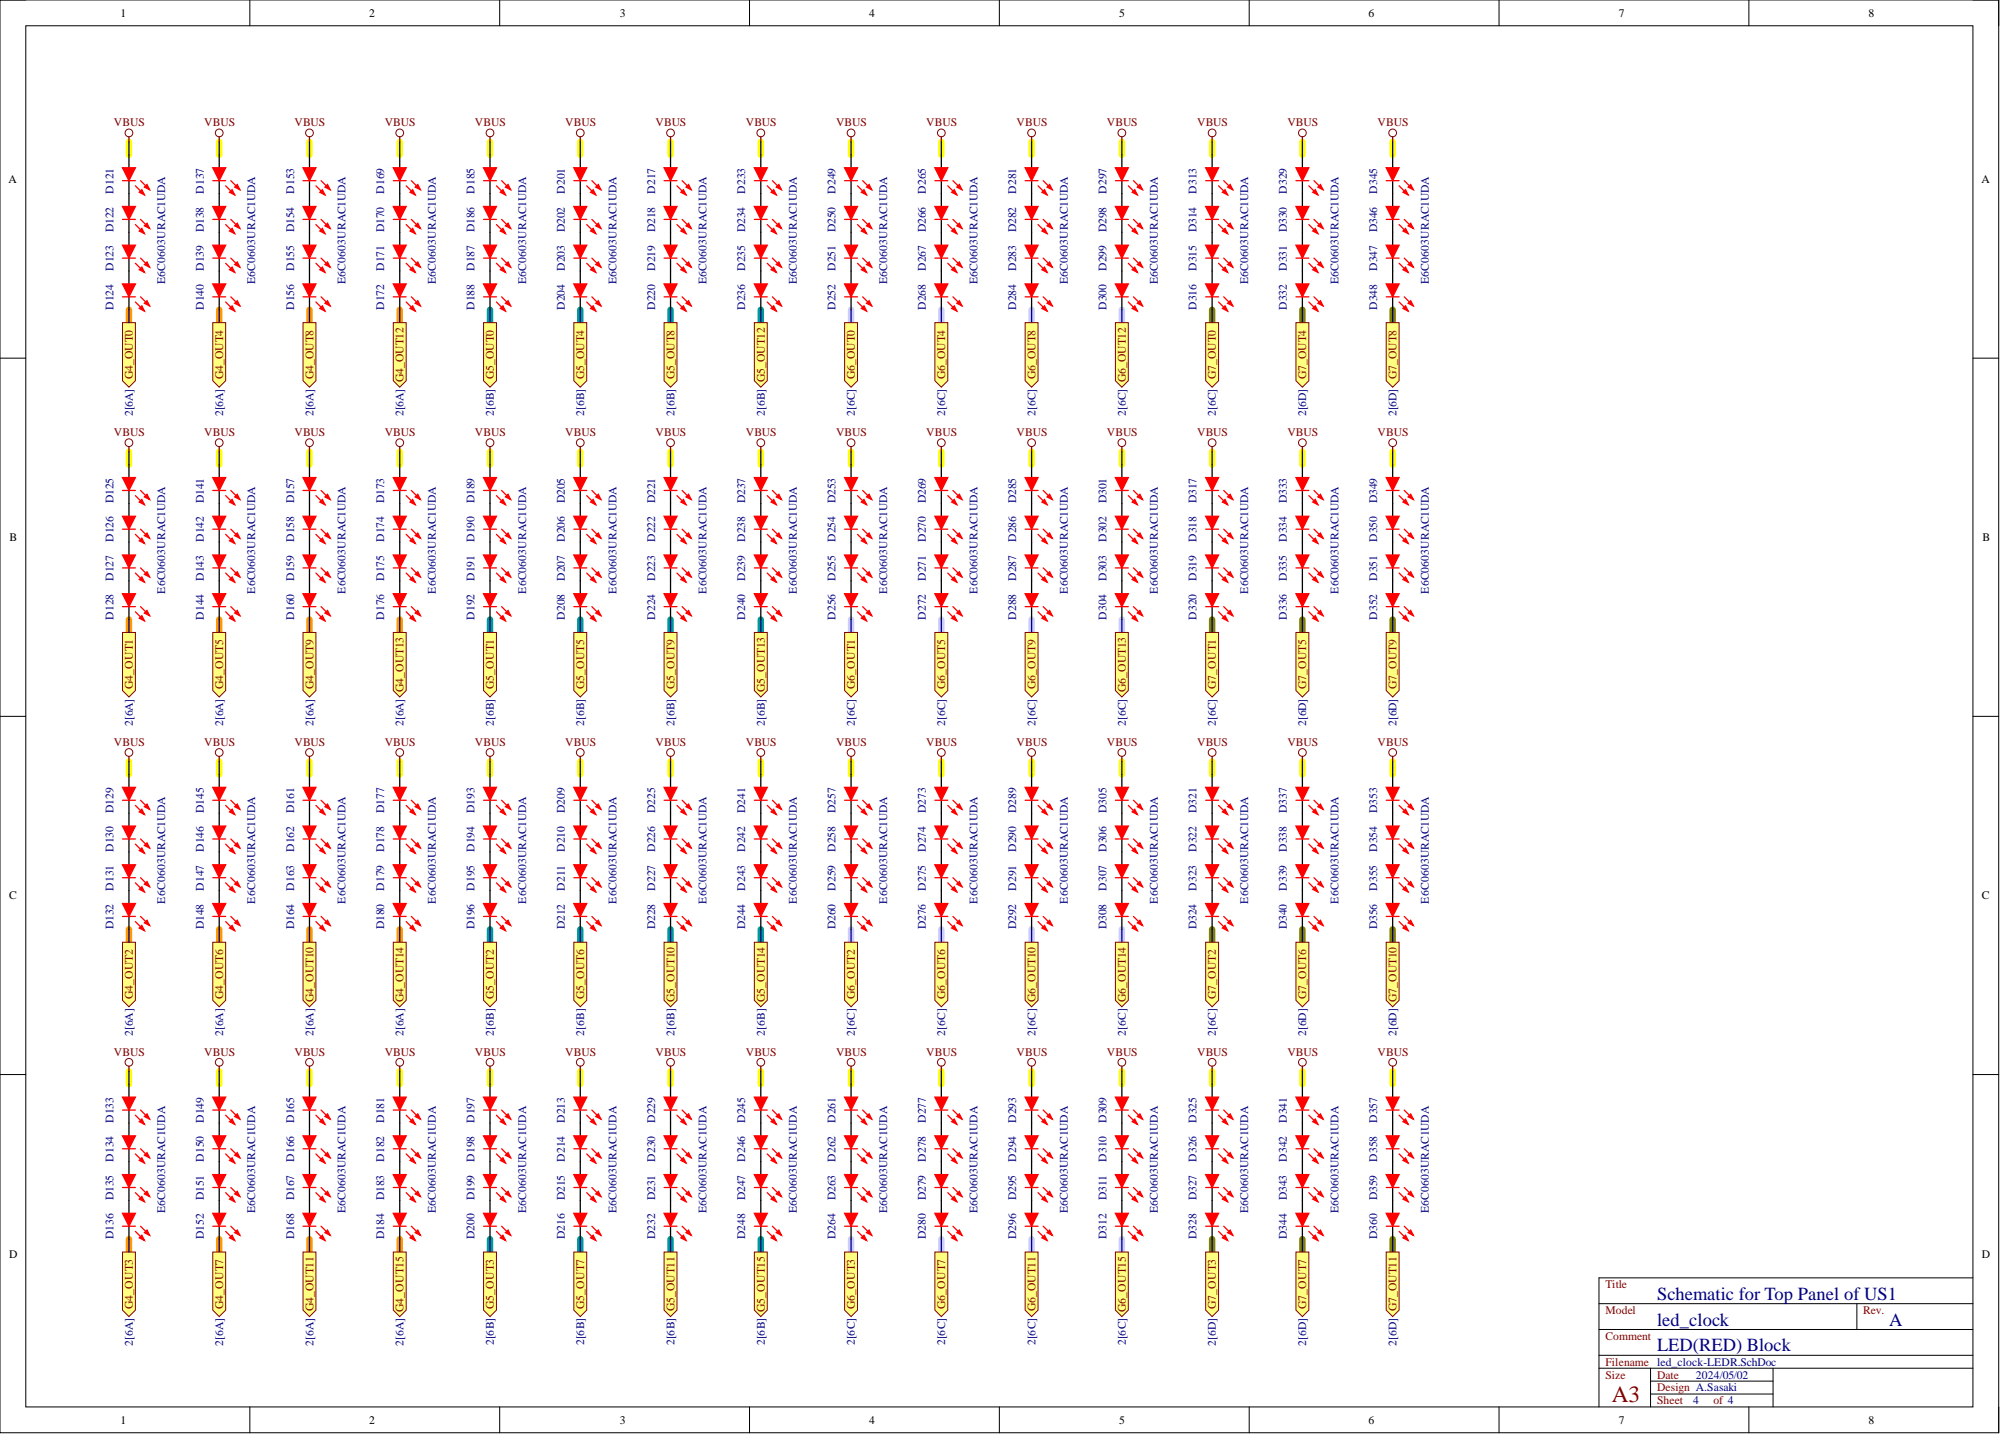
[picture p57: page 4]
