tadashi101/teen_circle/sch/Rev2/led_clock_power.pdf

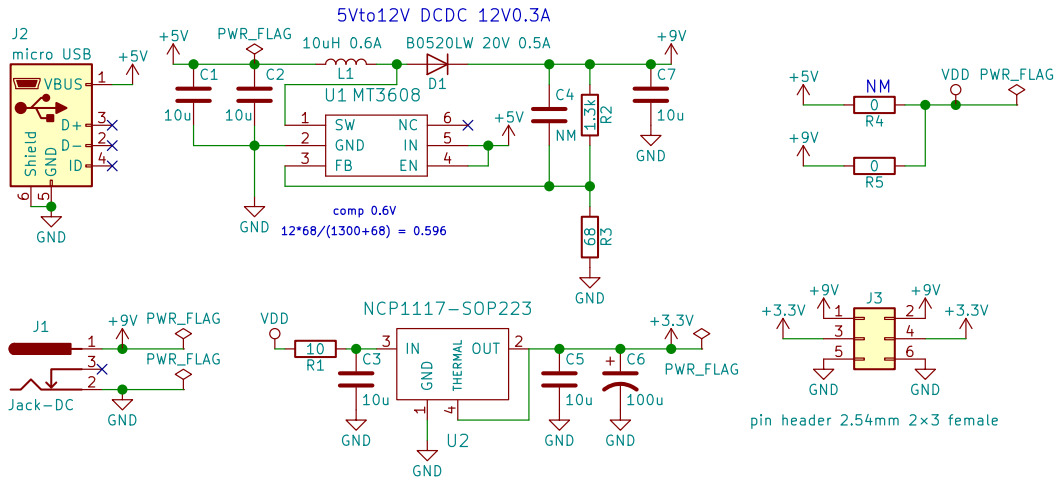
[picture p58: page 1]

1 OUT 2
pin header 2.54mm 2×3 female GND
