tadashi101/teen_circle/sch/Rev2/led_clock.pdf

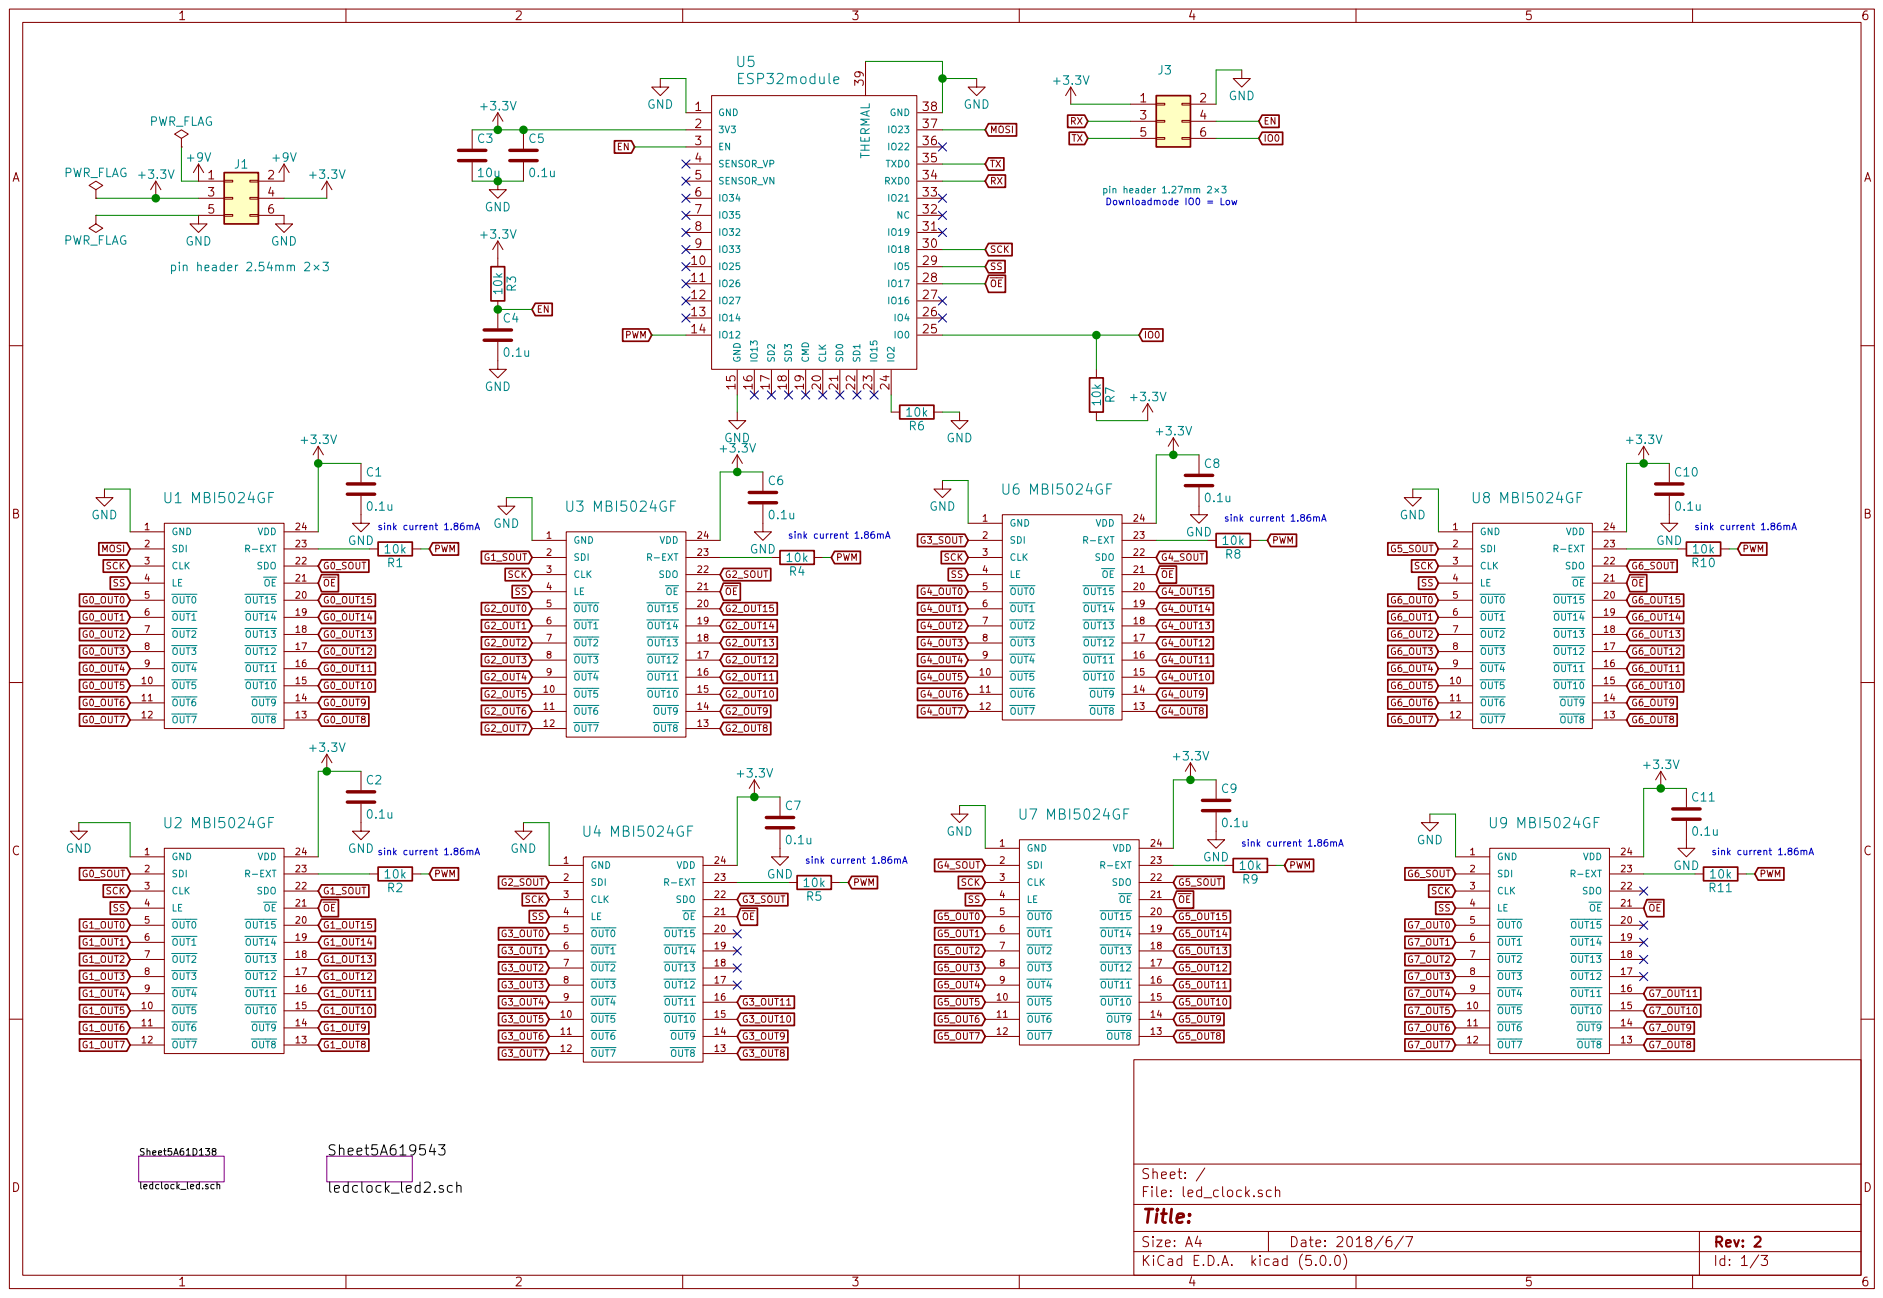
[picture p59: page 1]

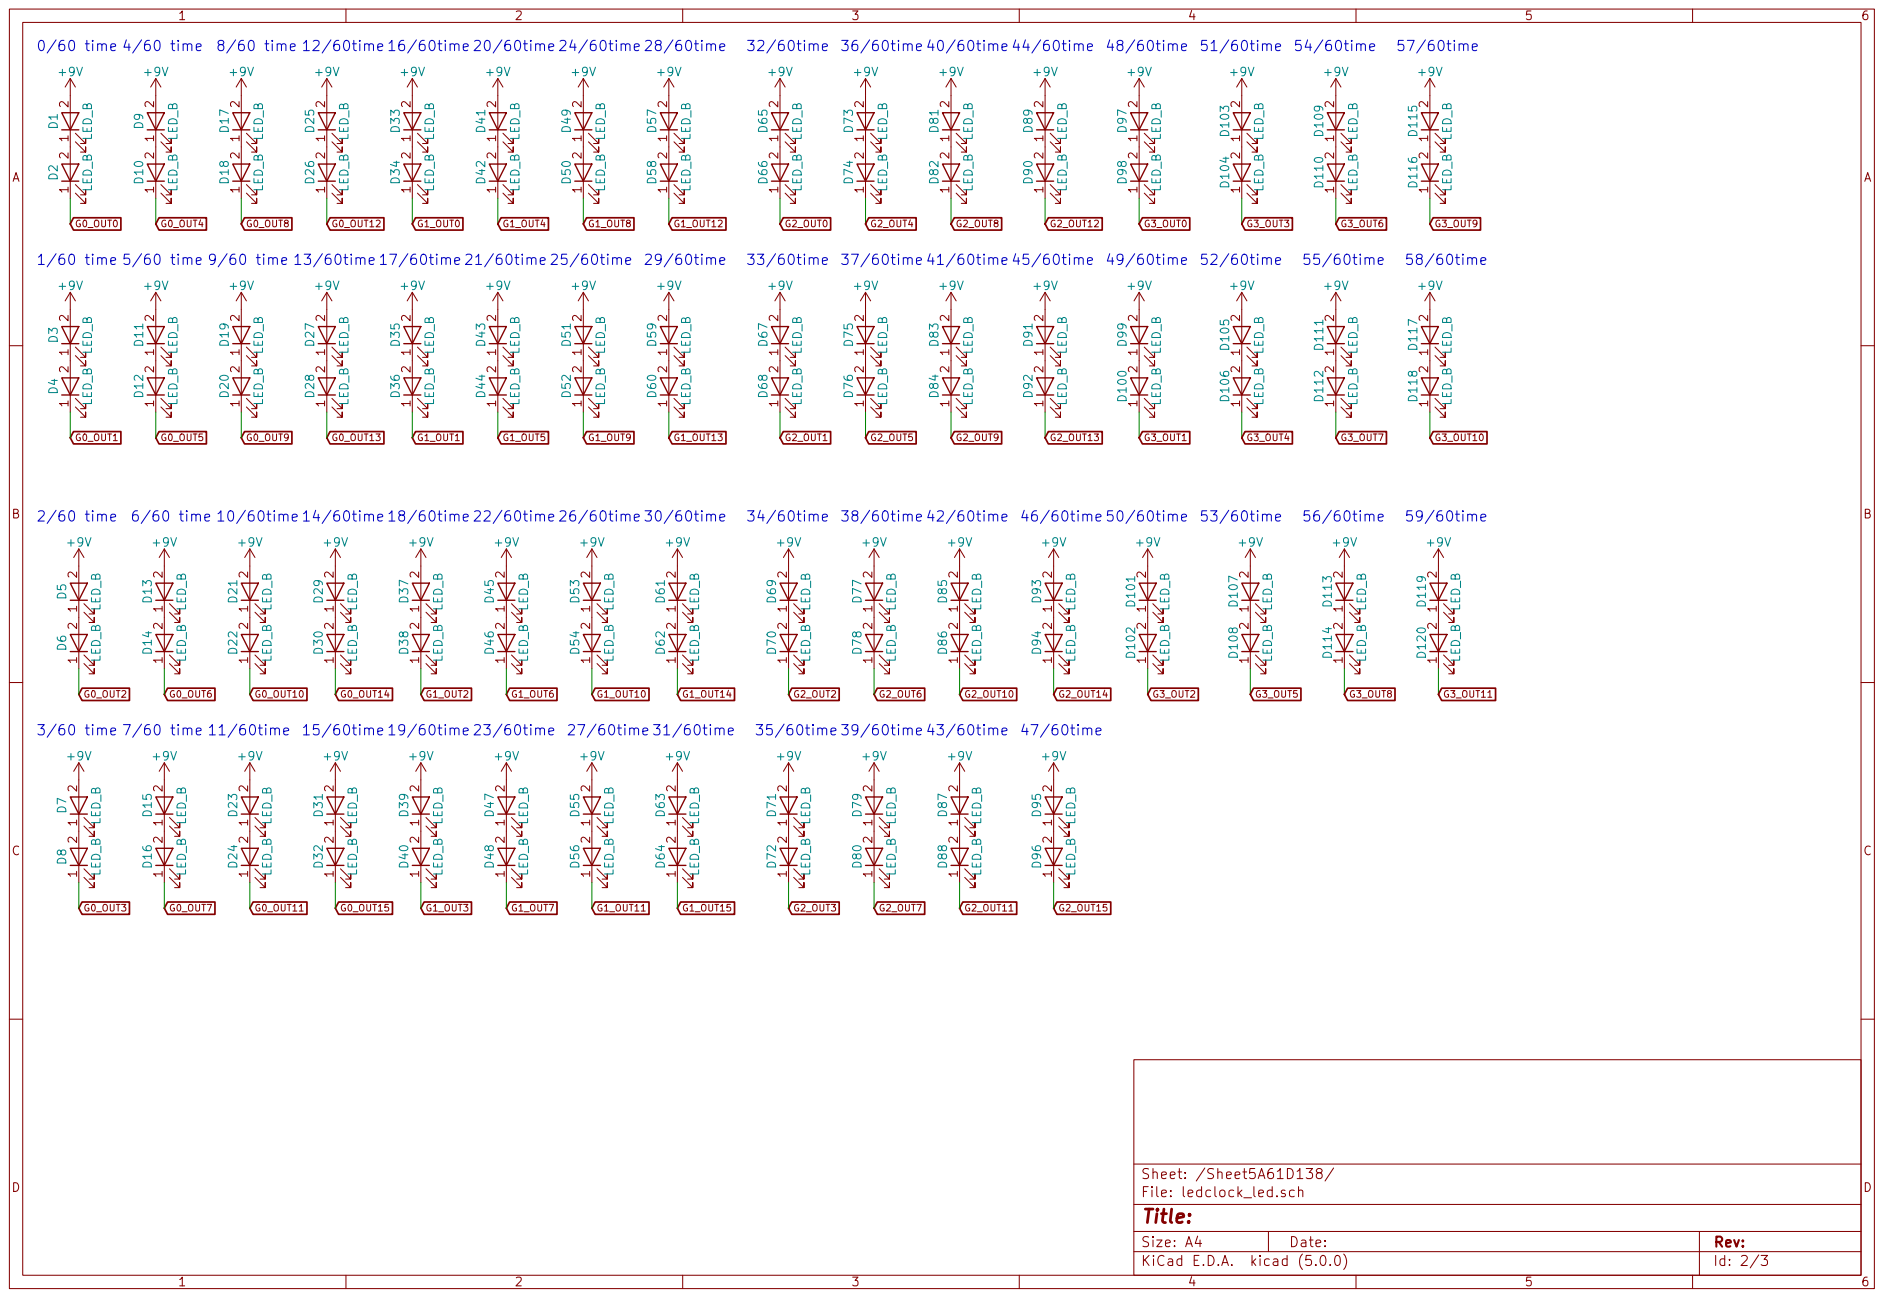
[picture p60: page 2]

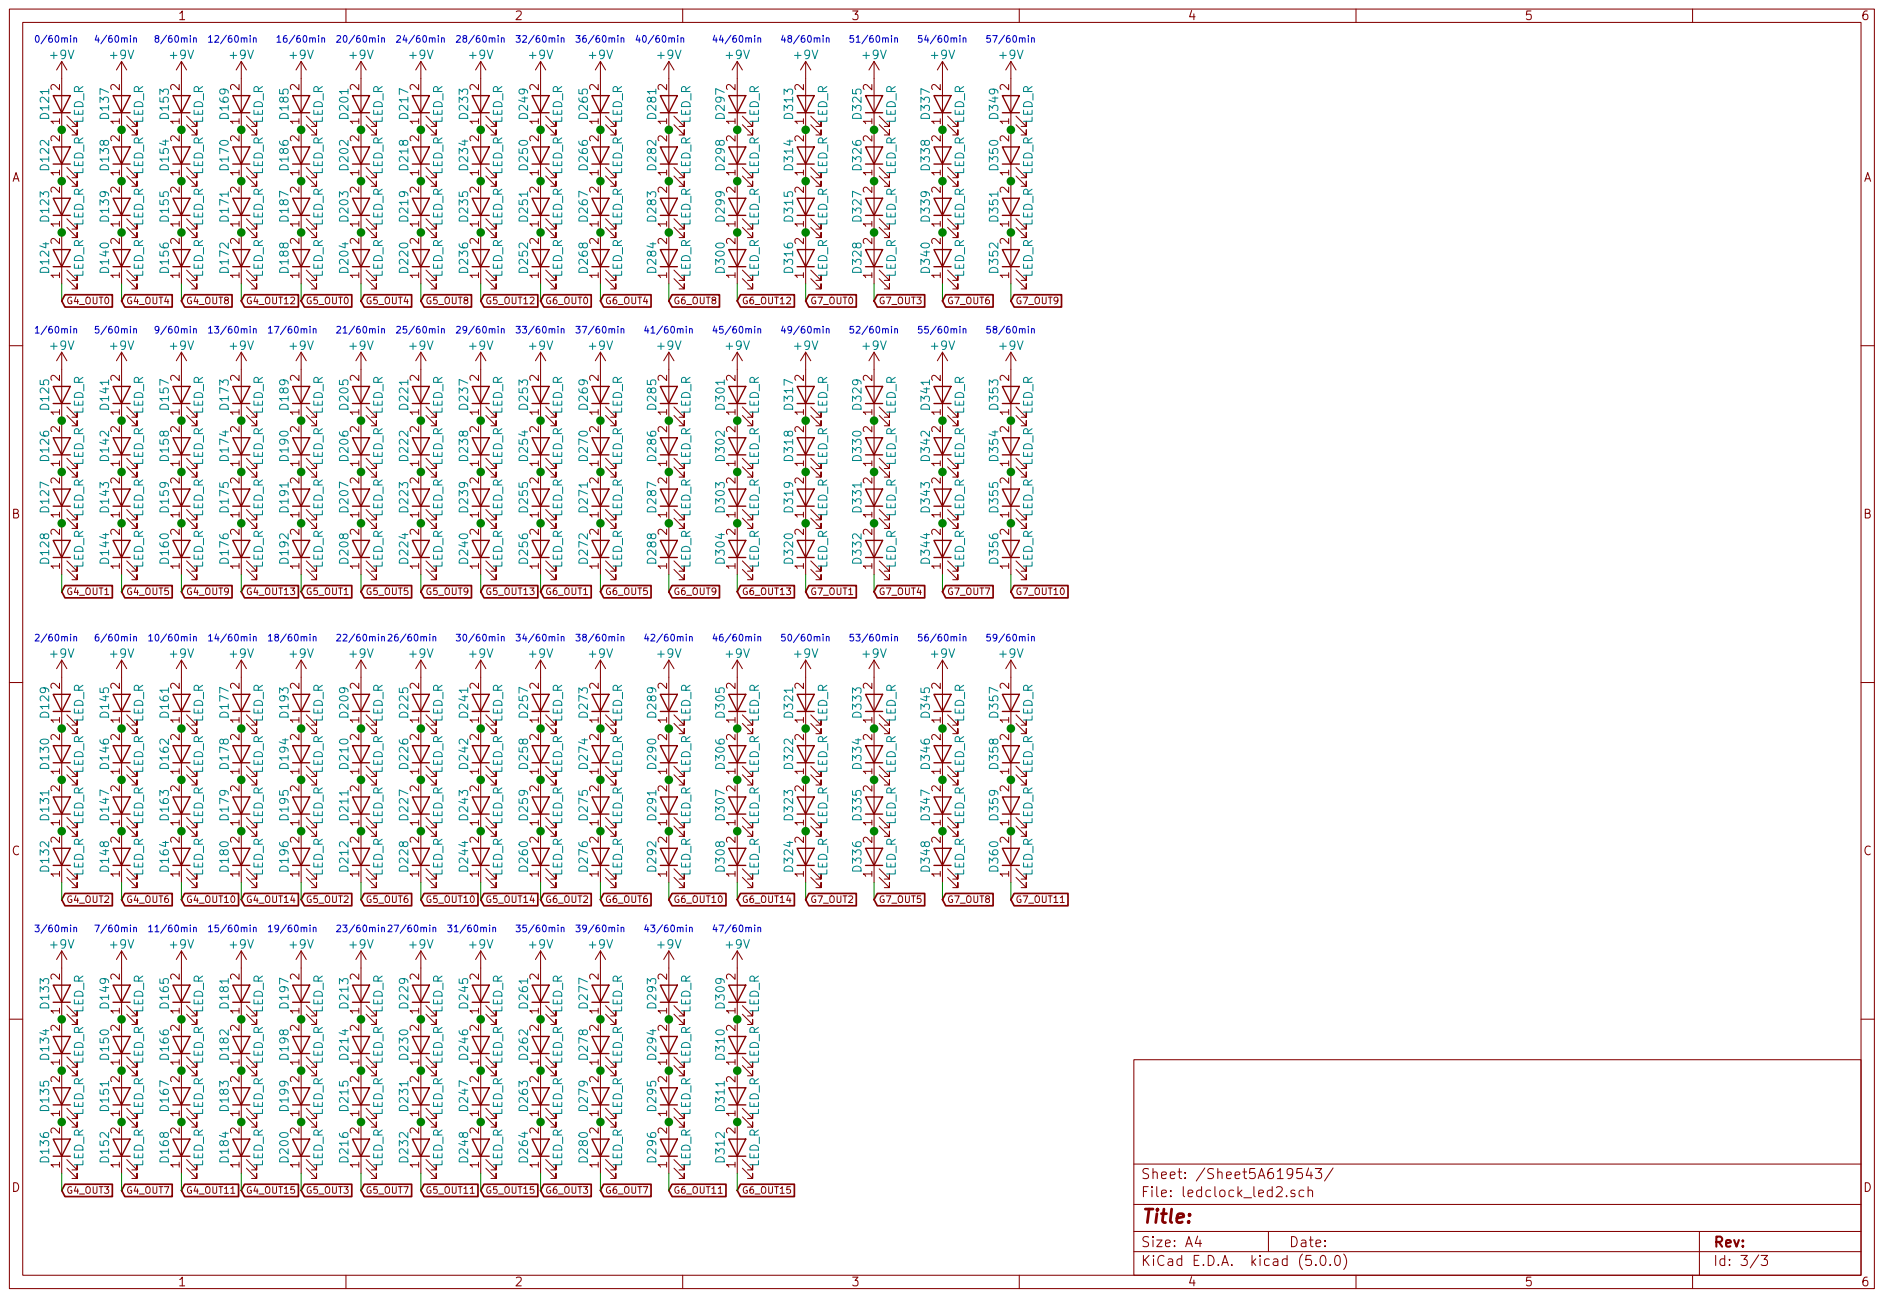
[picture p61: page 3]
