tadashi101/teen_circle/sch/Rev1/teen_circle_led.pdf

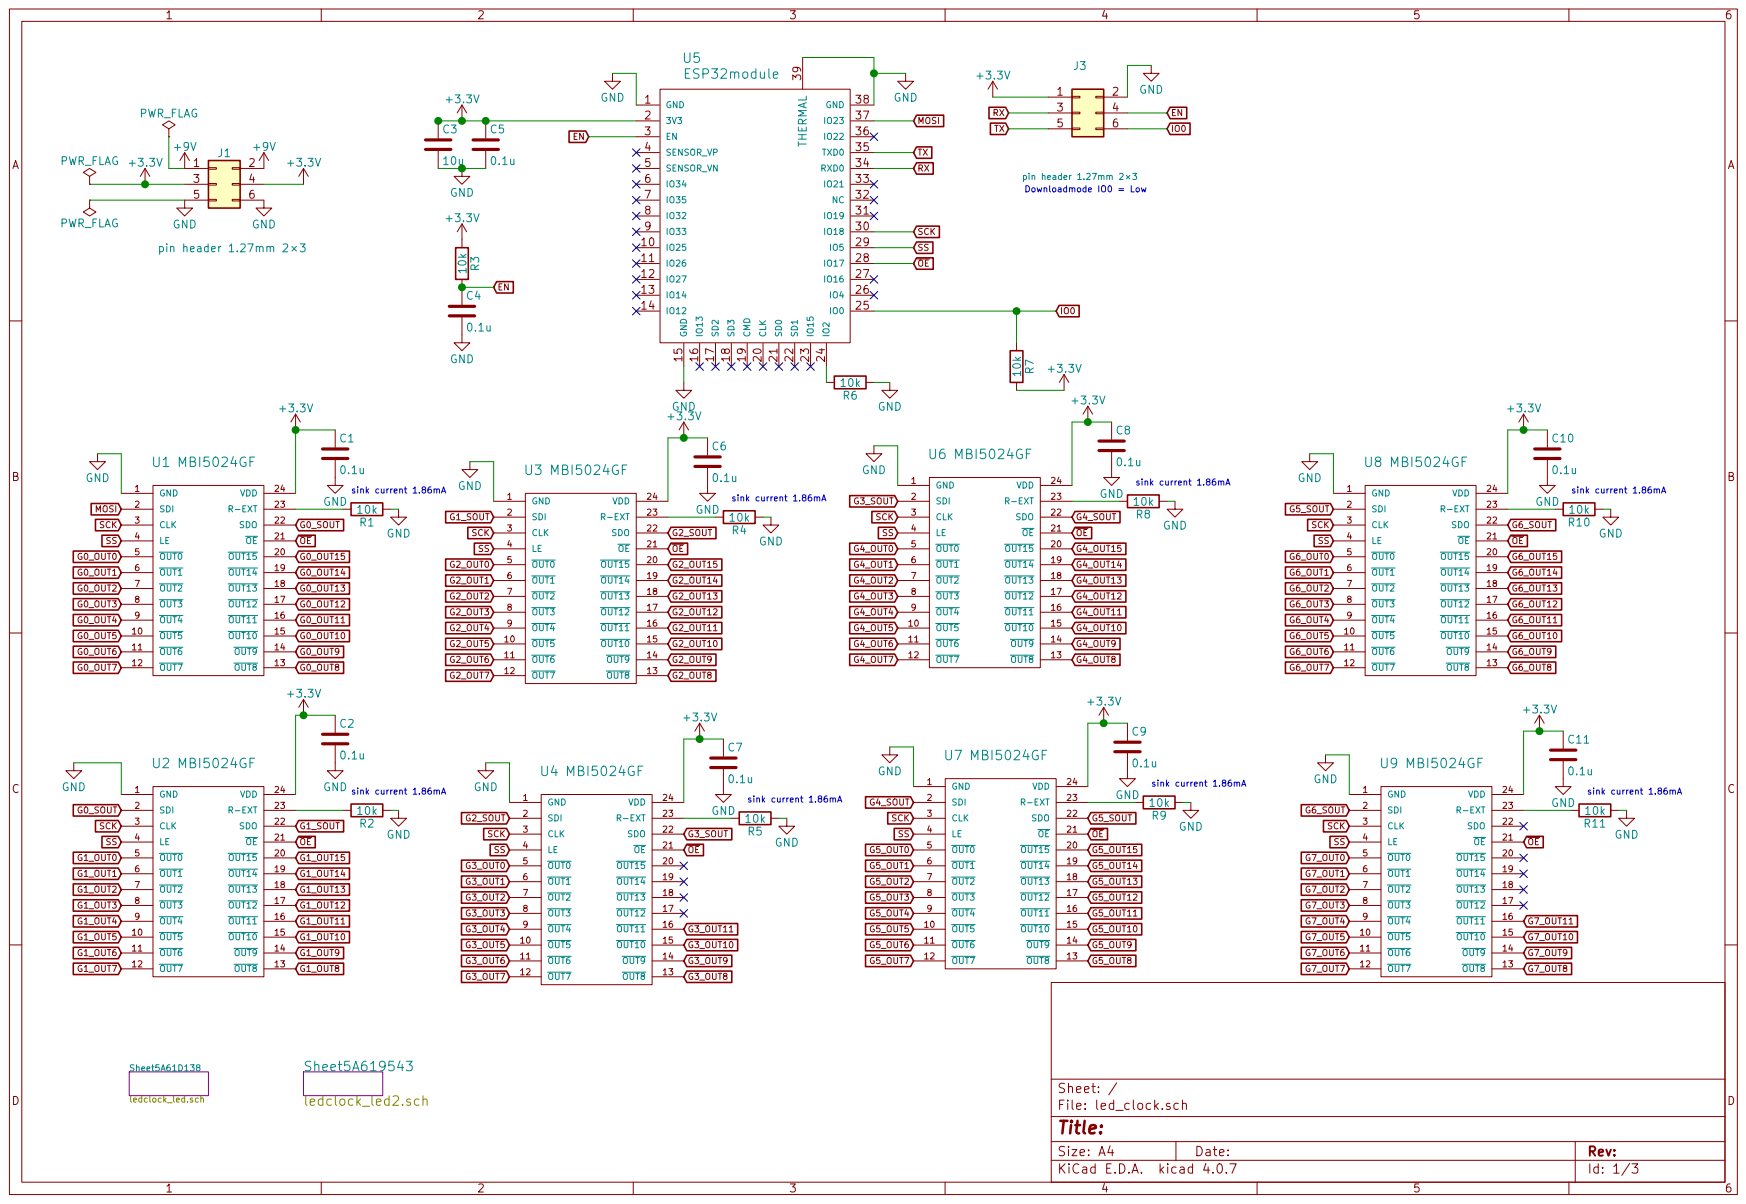
[picture p62: page 1]

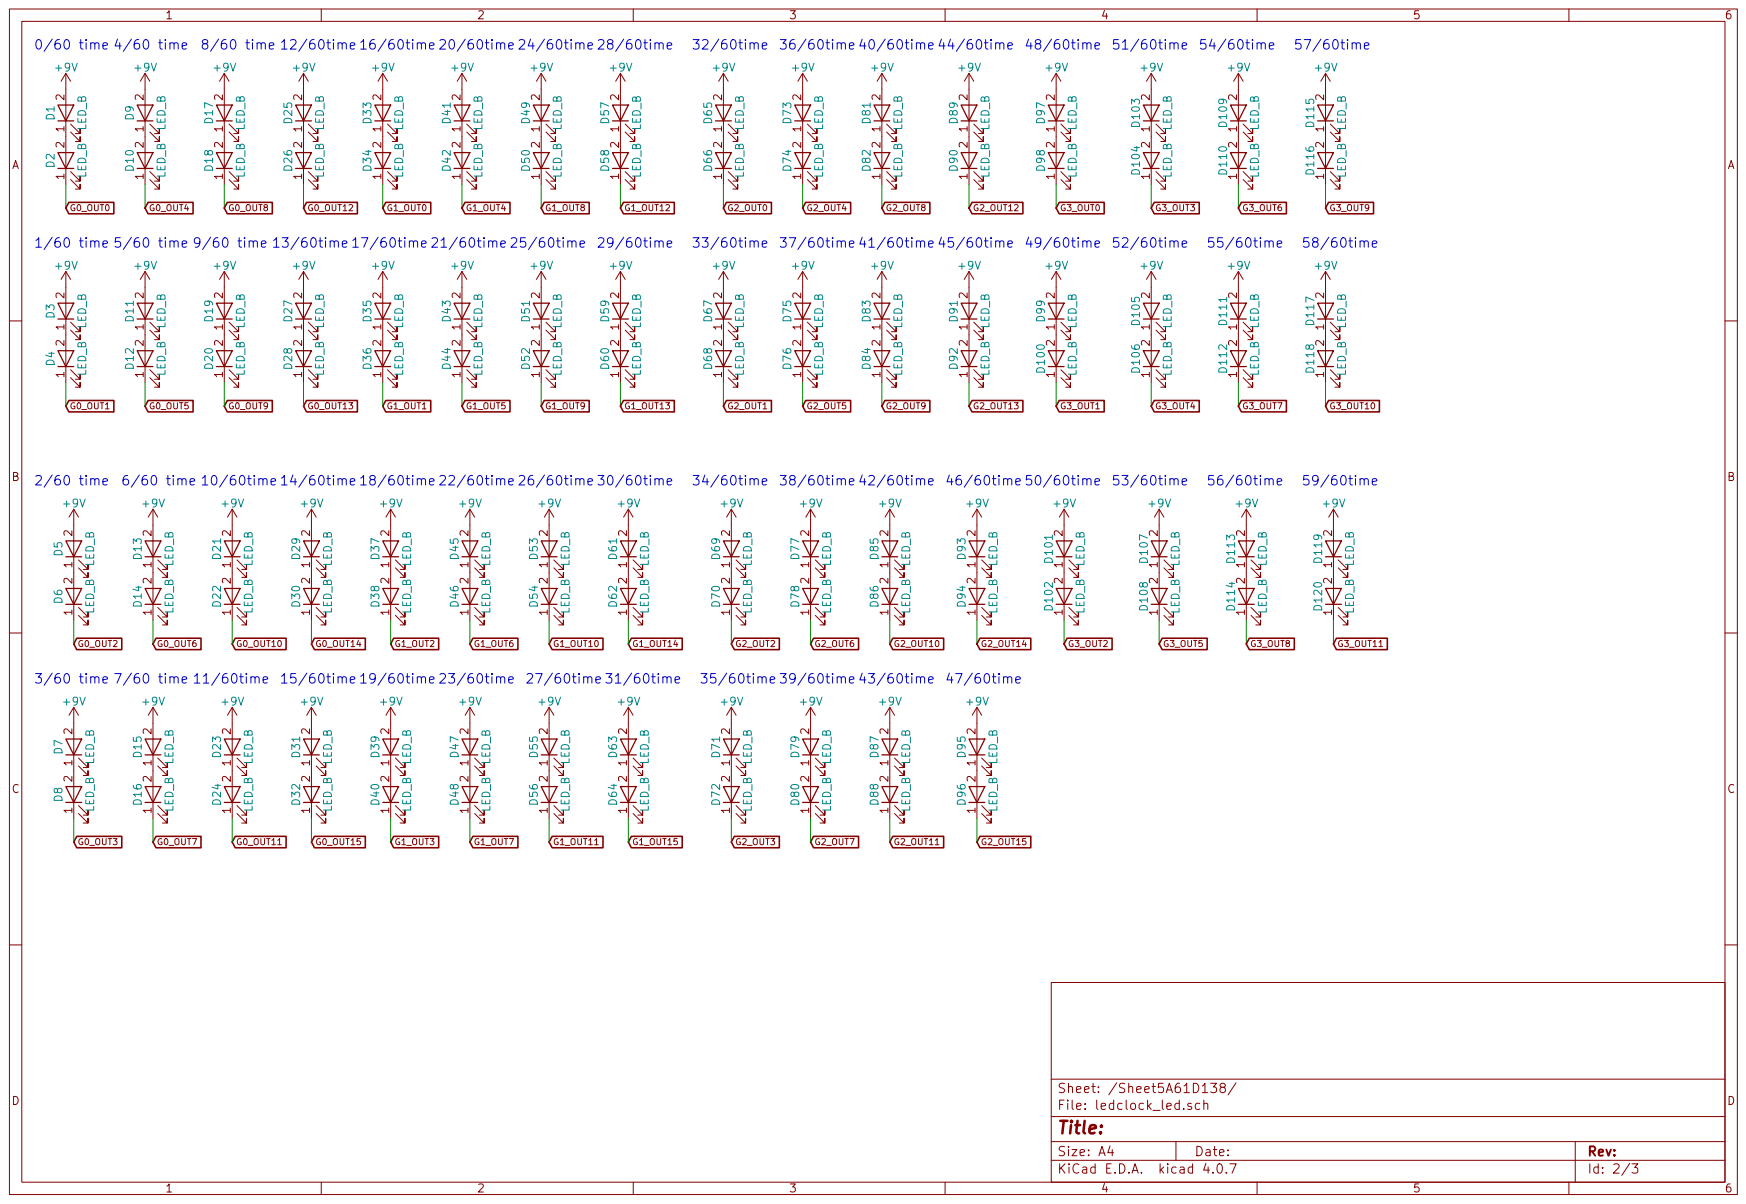
[picture p63: page 2]

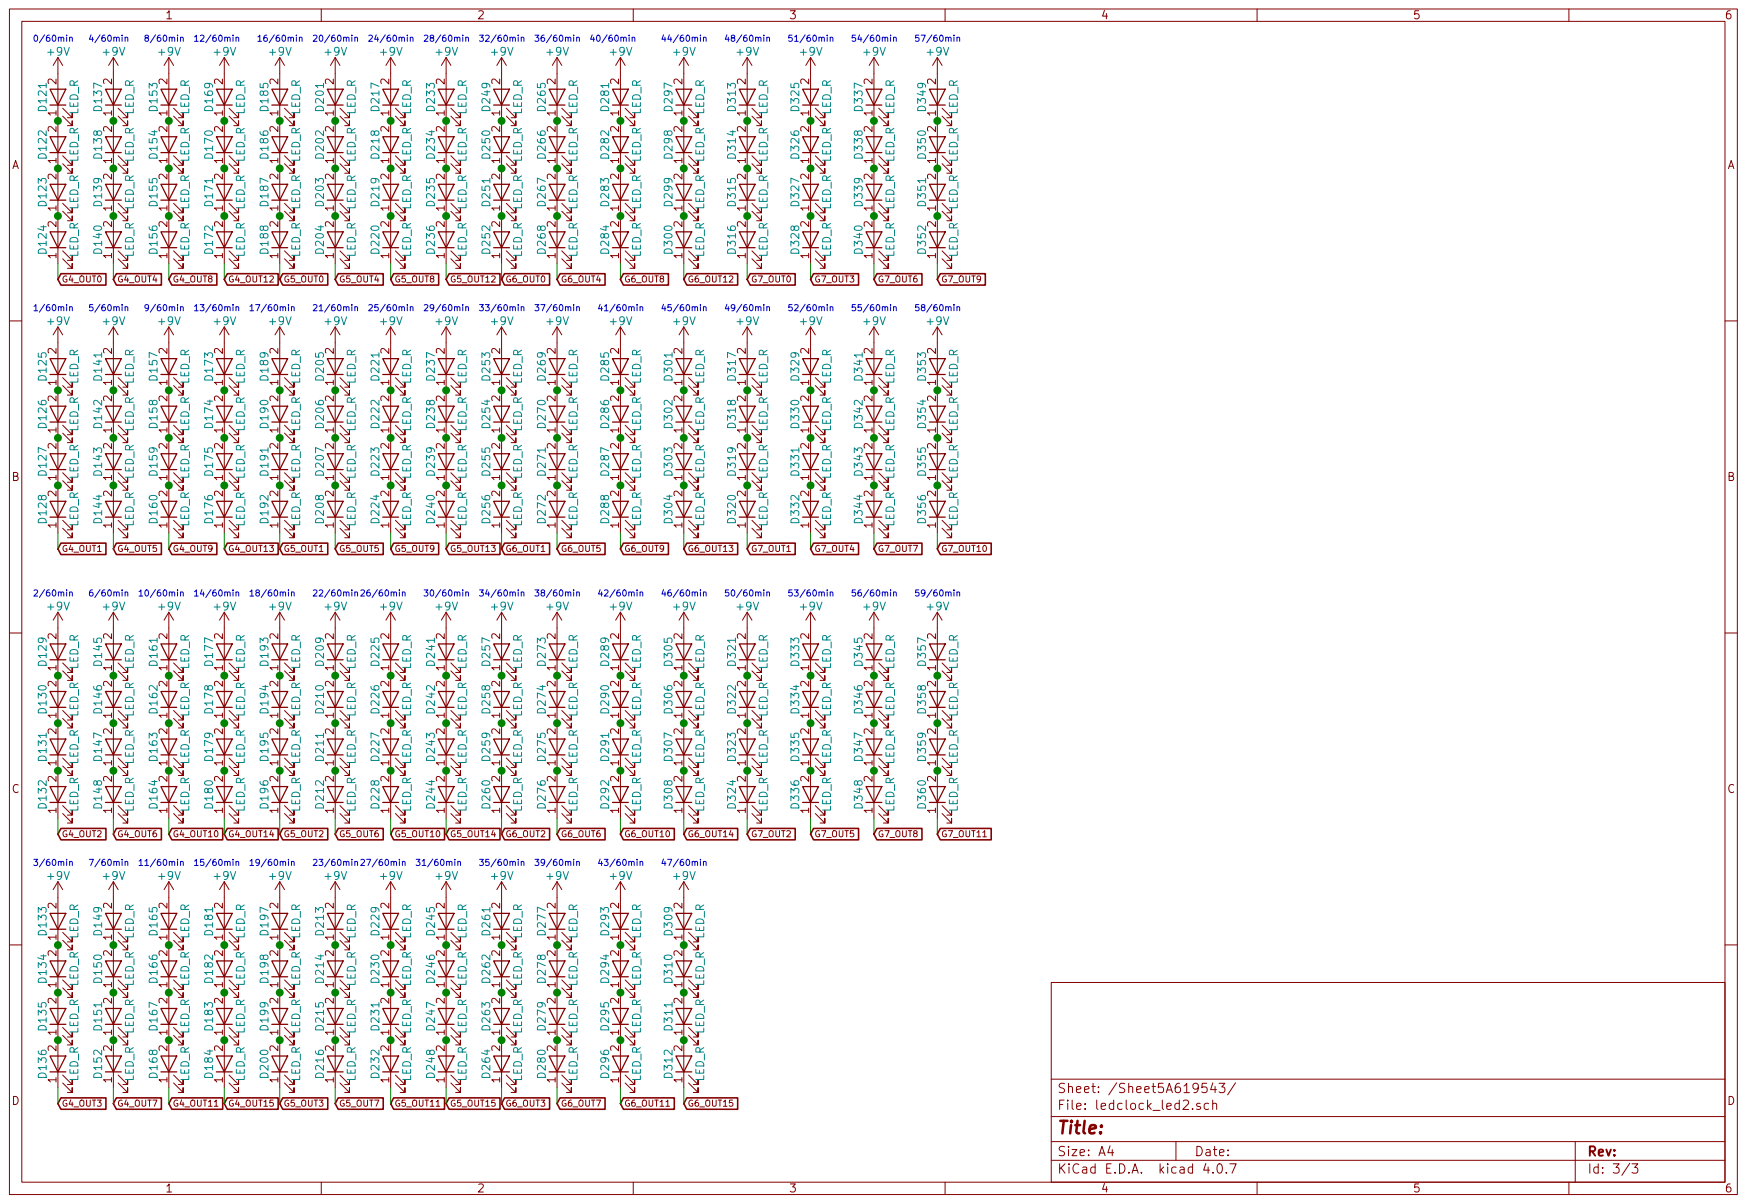
[picture p64: page 3]
