tadashi101/teen_circle/sch/Rev1/teen_circle_power.pdf

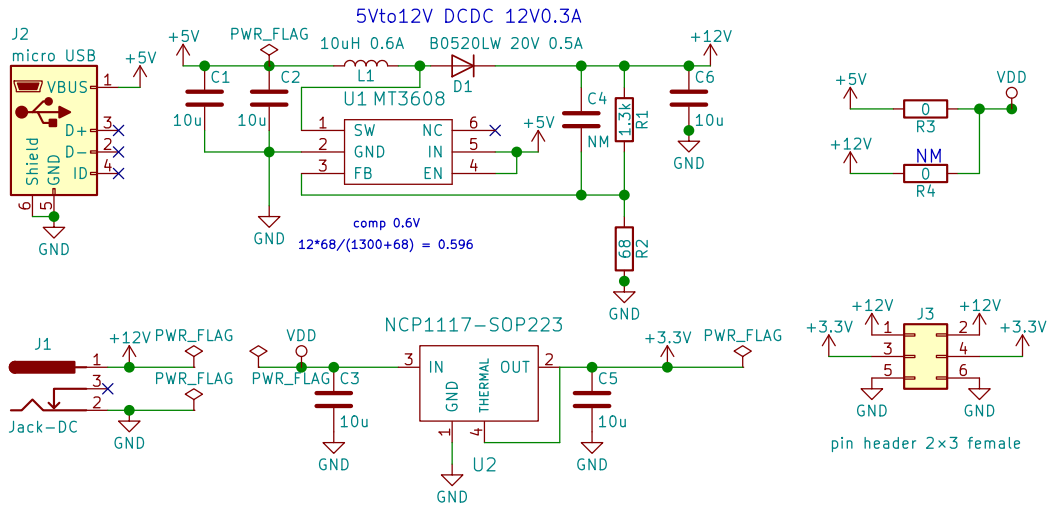
[picture p65: page 1]
