tadashi101/teen_circle/(commit log)

2018-05-08 写真サイズ変更
2018-05-08 LED半田付けまで記載
2018-05-08 誤記修正
2018-05-08 ファイル修正
2018-05-08 一旦削除
2018-05-08 写真修正
2018-05-08 LEDドライバまで記載
2018-05-09 LEDドライバまで記載2
2018-05-09 ESP32モジュールまで記載
2018-05-09 JPG修正
2018-05-09 0.1uまで
2018-05-09 組み立て説明はTバーの接続以外完成
2018-05-09 13修正
2018-05-10 時刻の読み方説明画像追加
2018-05-10 画像位置修正
2018-05-10 dial.md修正
2018-05-11 ワッシャーとかTバーの画像追加
2018-05-11 buildguideの項目は全て埋めた
2018-05-11 内容物にワッシャー追加
2018-05-11 READMEにdocuments追加
2018-05-11 表記ミスを修正
2018-05-11 buidguide 修正
2018-05-11 注意点追加
2018-05-12 文末に句点があったので除去
2018-05-12 文章の修正
2018-05-12 文章を修正
2018-05-12 readme画像変更
2018-05-13 デモモード追記
2018-05-13 usage表記ミス修正
2018-05-13 usage修正
2018-05-13 mode2追加
2018-05-13 モード追記
2018-05-17 ファームウェア書き込み方法追加
2018-05-17 flash修正
2018-05-17 flash.md修正
2018-05-17 README追記
2018-05-18 flash.md冒頭追記
2018-08-27 Rev2の追加
2018-08-27 READMEのRev2追加
2018-08-27 Rev2追加
2018-08-27 firmwareにRev2追加
2018-08-27 Rev2のピンヘッダとか電源基板の変更を記載
2018-08-29 10uの数を1→3に
2018-08-29 buildguide追記
2018-08-31 明るさ比較画像追加
2018-08-31 画像サイズ調整
2018-08-31 文言修正
2018-08-31 READ.MEの文言修正
2018-09-10 Unix Time と struct tm の変換に標準ライブラリを使うようにした
2018-09-10 NTP 対応
2018-09-10 OTA アップデート機能を追加
2018-09-10 clang-format -style=WebKit で整形
2018-09-10 Wi-Fi の設定情報を、ヘッダファイルに分けた
2018-09-10 コード整理
2018-09-10 README.md を追加
2024-05-25 ArduinoJson v7系に対応
2024-05-26 WiFiManager(https://github.com/tzapu/WiFiManager)を統合、それに伴いESPAsyncWebServerを廃止 Brightnessの値をSPIFFSに保持するように変更 CLOCKモードに変更した時にbrightnessの値をLEDの明るさに反映させるように変更 未使用の変数を削除 WiFiManagerのStyleに合わせたsetting_new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
2024-05-26 Rev3回路図追加
2024-06-01 APのSSIDにMACアドレスの下位3バイトを表示させるように変更 説明文の追記修正
2024-06-01 Update README.md
    表示が崩れていたのを修正
2024-06-01 Update usage_2.md
    表示のされ方を修正
2024-06-01 ホスト名にMACアドレスの下位3バイトを加えるように変更
